eYSIP-2017/Fi_Pi_/Readme.txt

Hello,
This repo contains the documentation and codes of the project 
FiPi- Adapter board development for Firebird V using Raspberry Pi
