eYSIP-2017/Fi_Pi_/Project Report/report.pdf

## eYSIP2017

### Fi-Pi Raspberry-Pi Adaptor

### Board for Firebird-V

### Interns:- Milanpreet Singh Tejaswini A Mentors:- Rutuja Ekatpure Deepa Avudiappan Duration of Internship: 22/05/2017 − 07/07/2017

2017, e-Yantra Publication

# Fi-Pi Raspberry-Pi Adaptor Board for Firebird-V

## Abstract

The project aims at developing Raspberry-pi based Adaptor board for Firebird series Robots.As Raspberry- Pi can cater to more applications specifically in domain of image processing and IOT and provides a new feature of onboard computing which was not present in earlier versions Firebird series. Main features included in this Raspberry- pi based firebird are :-

- Differnet communication choices i.e through XBEE,Bluetooth,USB,DB9, or any serial communication protocol of your choice can used for communication purposes.
- Interfacing Camera on board and live image capturing and video streaming enhances its capabilities and horizon of its applications in different domains.

1

### Completion status

The work flow of the project designed and its completion status is as follows:-

Task | Completion Status | Remarks
Understanding Fire-bird and Raspberry-Pi | Completed | Firebird and Raspberry -pi were studied and pins of firebird mapped properly and BAsic op-erations of Raspberry -Pi werev studied
Interfacing ADC and port Expander | Completed | ADC MCP3008 and Port Ex-pander MCP23017 were inter-faced with raspberry-pi and fire-bird by enabling spi and i2c com-munication and installing pack-ages serial and smbus
Powering circuit for pi | Completed | A circuit for powering Raspberry-pi using LM7805BT with 3A cur-rent capacity was designed
Communication pro-tocols | Completed | Communication protocols like XBEE,DB9,USB were tested by sending commands to firebird through pi
LCD and Motion con-trol | Completed | LCD in 4 bit mode was interfaced using pi and motors were oper-ated at different speeds
Camera interfacing | Completed | Camera was interfaced with pi and images, videos were saved on pi.
Adaptor Board PCB | Completed and revised to new version | PCB was designed and tested with firebird.A newer version was designed with some changes
Manual | Completed | Both Hardware and Software manuals were designed incuding all the features ob board with their codes .
www.e-yantra.org | 2

1.1. HARDWARE PARTS

## 1.1 Hardware parts

- List of hardware
1. Raspberry Pi
Download Datasheet , (https://www.raspberrypi.org/documentation/.../RPI-CM-DATASHEET-V1_0.pdf) Vendor Details (http://www.amazon.in/Raspberry-Pi-Model-1GB-Complete/dp/B00T2U7R7I)

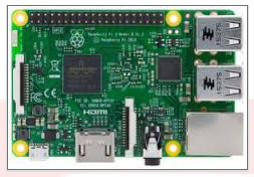
[picture p16: figure]

Figure 1.1: Raspberry Pi

2. FireBird V Robot
Download Datasheet , Vendor Details (http://www.nex-robotics.com/products/fire-bird-v-robots/fire-bird-v-atmega2560-robotic-research-platform.html)

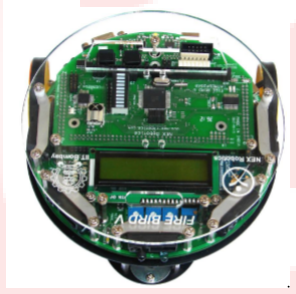
[picture p17: figure]

Figure 1.2: FireBird V Robot

3. MCP23017 IC
Download Datasheet , Vendor Details (http://www.smddevices.com/)

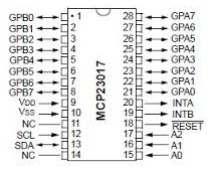
[picture p18: figure]

Figure 1.3: MCP23017 IC

www.e-yantra.org | 3

1.1. HARDWARE PARTS
4. MCP3008 IC
Download Datasheet , (https://cdn-shop.adafruit.com/datasheets/MCP3008.pdf) Vendor Details (http://www.dnatechindia.com/MCP3008-10-Bit-ADC.html)

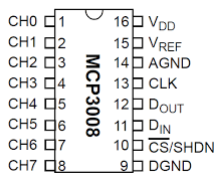
[picture p19: figure]

Figure 1.4: MCP3008 IC

5. FT232 IC
Download Datasheet , Vendor Details (http://www.dnatechindia.com/ft-232-usb-uart-ic.html)

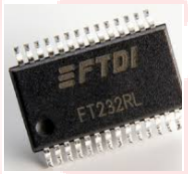
[picture p20: figure]

Figure 1.5: FT232 IC

6. MAX202 IC
Download Datasheet , Vendor Details (https://www.tanotis.com/products/tanotis-2pcs-maxim-integrated-products-max202-max202ese-max202ese)


Figure 1.6: MAX202 IC

7. LM324 IC
Download Datasheet , Vendor Details (http://www.dnatechindia.com/LM324.html)
www.e-yantra.org | 4

1.1. HARDWARE PARTS

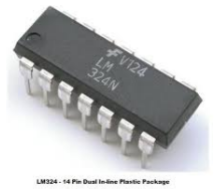
[picture p21: figure]

Figure 1.7: LM324 IC

8. LM7805 IC
Download Datasheet , (https://www.sparkfun.com/datasheets/Components/LM7805.pdf) Vendor Details (http://www.dnatechindia.com/LM7805.html)

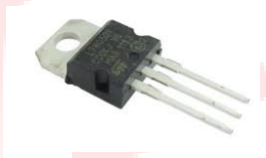
[picture p22: figure]

Figure 1.8: LM7805 IC

9. LM1117 IC
Download Datasheet , Vendor Details (http://www.dnatechindia.com/lm-1117-1-8-v-smd-voltage-regulator.html) Vendor Details (http://www.dnatechindia.com/LM7805.html)

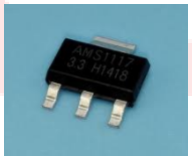
[picture p23: figure]

Figure 1.9: LM1117 IC

10. LED
11. Resistor
12. Bargraph LED
13. Switches
14. Header pins
www.e-yantra.org | 5

1.2. SOFTWARE USED

## 1.2 Software used

- MobaXterm Download Link (http://mobaxterm.mobatek.net/MobaXterm_Setup_9.4.msi)
Personal Edition 9.4
- Raspbian Jessie Download Link (https://downloads.raspberrypi.org/raspbian_latest) Disk Image Version 2
- Autodesk Eagle Download Link (http://www.cadsoftusa.com/download-eagle/) Version 8.2.1
- XCTU Download Link (http://www.digi.com/products/xbee-rf-solutions/xctu-software/xctu#productsupport-utilities)
- Win32 Disk Imager Download Link (http://sourceforge.net/projects/win32diskimager/)
- SD card Formatter Download Link (https://www.sdcard.org/downloads/formatter_4/eula_windows/)
- DHCP server Download Link (http://www.dhcpserver.de/cms/release_notes/2-5-2/) Version 2.5.2
- Serial Terminal Download Link (https://serial-port-terminal.en.softonic.com/)

## 1.3 Assembly of hardware

### Circuit Diagram

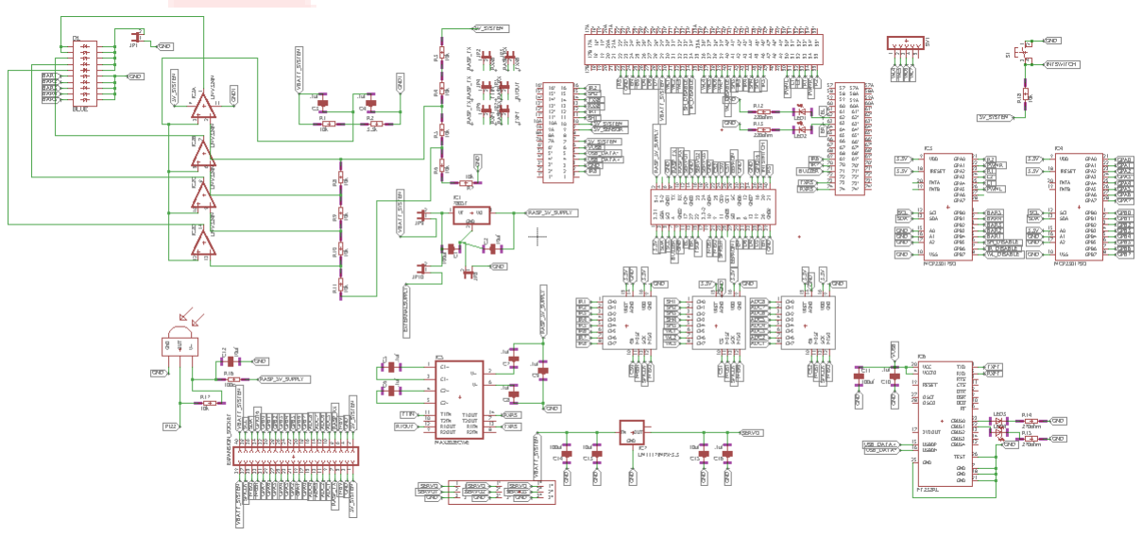
[picture p24: figure]

Figure 1.10: schematic

For more details refer to github link Fi-Pi schematics (https://github.com/eYSIP-2017/eYSIP-2017_Fi_Pi/blob/master/Documents/PCB_Schematics/Fi-Pi.sch)

www.e-yantra.org | 6

1.3. ASSEMBLY OF HARDWARE

### Eagle Layout

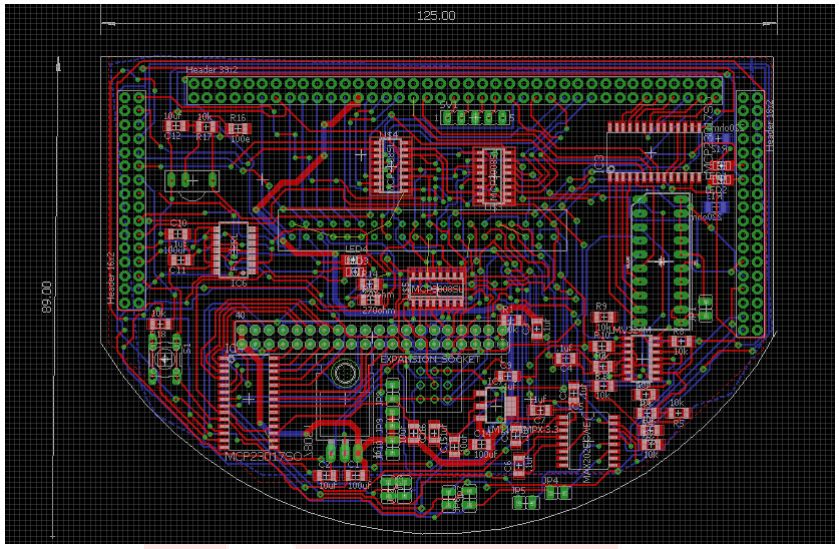
[picture p25: figure]

Figure 1.11: PCB board layout

For more details refer to github link Fi-Pi layout (https://github.com/eYSIP-2017/eYSIP-2017_Fi_Pi/blob/master/Documents/PCB_Schematics/Fi-Pi.brd)

## Steps for Assembling the parts

### Step 1

Get the PCB etched with the gerber file created from the eagle board layout.

www.e-yantra.org | 7

1.3. ASSEMBLY OF HARDWARE

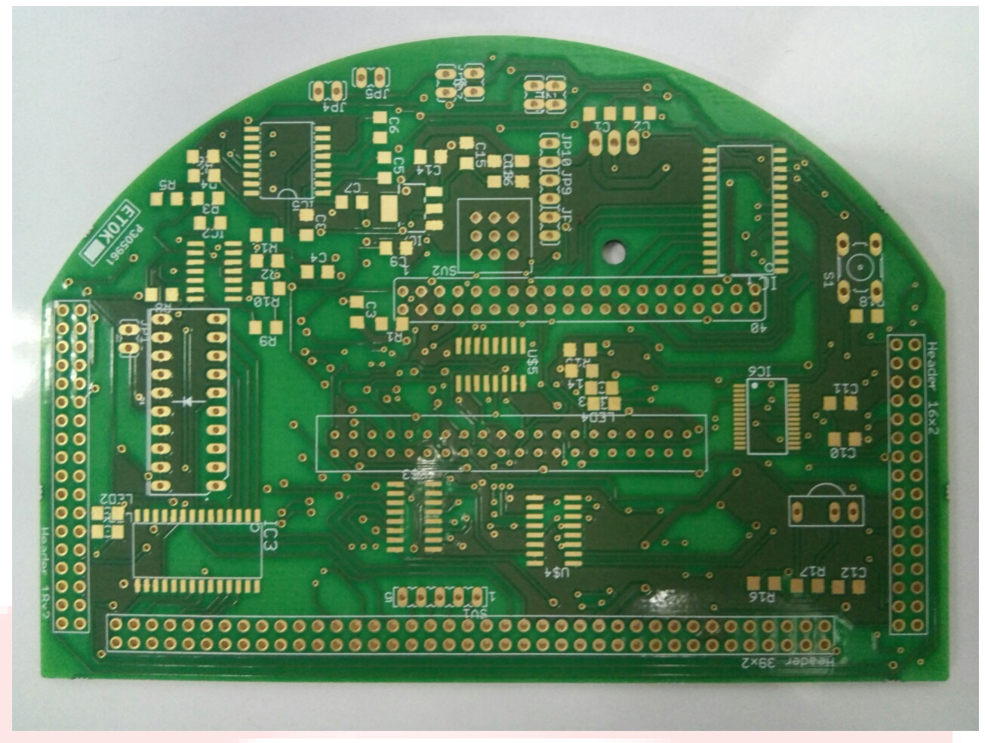
[picture p26: figure]

Figure 1.12: PCB board layout

### Step 2

Place the SMD and Through hole components appropriately in proper orientation and location. Finally solder them

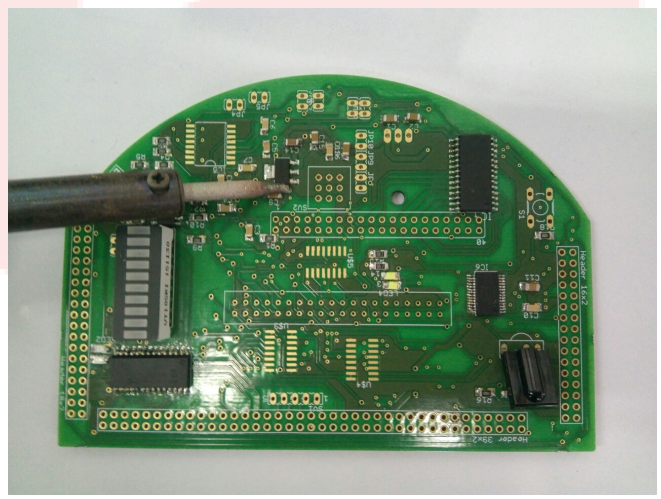
[picture p27: figure]

Figure 1.13: PCB board layout

### Step 3

The final PCB looks as shown below.

www.e-yantra.org | 8

1.4. SOFTWARE AND CODE

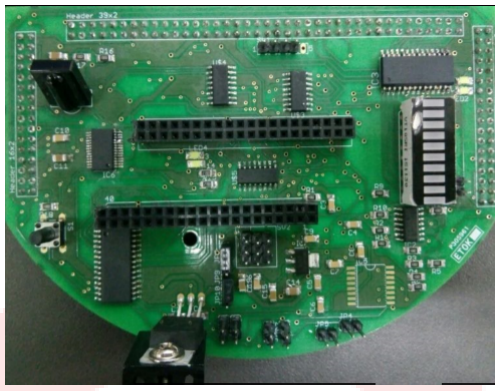
[picture p28: figure]

Figure 1.14: PCB board layout

## 1.4 Software and Code

Github link (https://github.com/eYSIP-2017/eYSIP-2017_Fi_Pi/tree/master/codes/Experiments) for the repository of code

## 1.5 Future Work

Raspberry-pi is a good option for IOT applications so a website can be designed which could be linked to the Raspberry-pi enabled Firebird and data from firebird can be regularly sent let be the sensor values and displayed on the site and stored for further applications.
It may help in tracking conditions of environment from internet and making plant watering bot by detecting plants in the garden through image processing and water them by detecting the humidity and hence watering accordingly.
www.e-yantra.org | 9

1.6. BUG REPORT AND CHALLENGES

## 1.6 Bug report and Challenges

Some changes in Hardware (PCB) have been made and a newer version of PCB is designed:-

- External powering port with external separate battery
- Raspberrypi pin header modified for plug and play directly
- Transistors are interfaced instead of jumpers for changing the communication platform from one to another and hence can be controlled through software means.
- Motors moved to Pi pin header and LCD to port expander beacuse LCD is somewhat useless as we can do ssh and check it on laptop and hence saving power.
www.e-yantra.org | 10

# Bibliography

[1] Raspbian Jessie OS Installation, https://www.engadget.com/2012/09/04/raspberrypi-getting-started-guide-how-to/
[2] SPI | and | I2C | communication | protocol
www.byteparadigm.com/applications/introduction-to-i2c-and-spiprotocols/
[3] I2C configuration https://learn.adafruit.com/ adafruits-raspberry-pilesson-4-gpio-setup/ configuring-i2c
[4] Pulse Width Modulation http://www.electronics-tutorials.ws/blog/ pulsewidth-modulation.html
[5] Software Interrupt https://www.techopedia.com/de

nition/22195/software-interrupt

[6] Port expander MCP23017 IC https://www.mathworks.com/examples/matlab/4547-add-digital-i-o-pins-to-raspberry-pi-hardware-using-mcp23017
[7] Queries regarding Raspberry Pi http://stackoverflow.com/questions/tagged/raspberrypi
[8] Libraries | for | progrmming | different | IC’s | or | modules
https://github.com/adafruit

11
