eYSIP-2017/Fi_Pi_/Documents/poster_final_update.pdf

# FIPI-Adaptor board for Firebird V using Raspberry Pi B+

### Milan Preet Singh, Tejaswini A, Mentors: Rutuja, Deepa

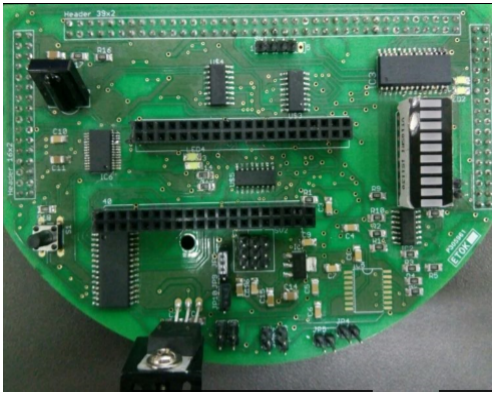
[picture p29: figure]
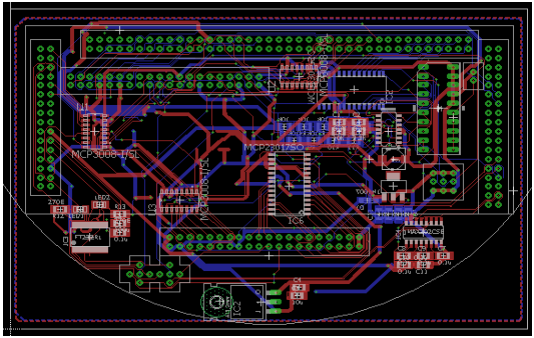
[picture p30: figure]

### e-Yantra Summer Internship Project 2017

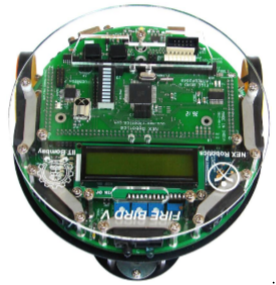
[picture p31: figure]

Currently Firebird V robot comes with ATMEGA2560, 8051, ARM7 adaptor board. Using a raspberry pi based adaptor board would add to the functionality of the robot. The idea is to integrate the features of RPi to Firebird V robot.
This will facilitate any
(1)On-board computations
(2)Imageprocessing(PiCamera )
(3) IOT applications
Objective | What does the Adaptor Board contain?

1.Raspberry Pi B+
2.MCP3008 ADC (8 channel, 10-bit, SPI ) 3.MCP23017 Port Expander (I2C protocol) 4.LM117 (Powering Servo motors)
5.Bar graph LED (Battery level indication) 6.Raspberry Pi port expansion socket

## Communication with Rpi

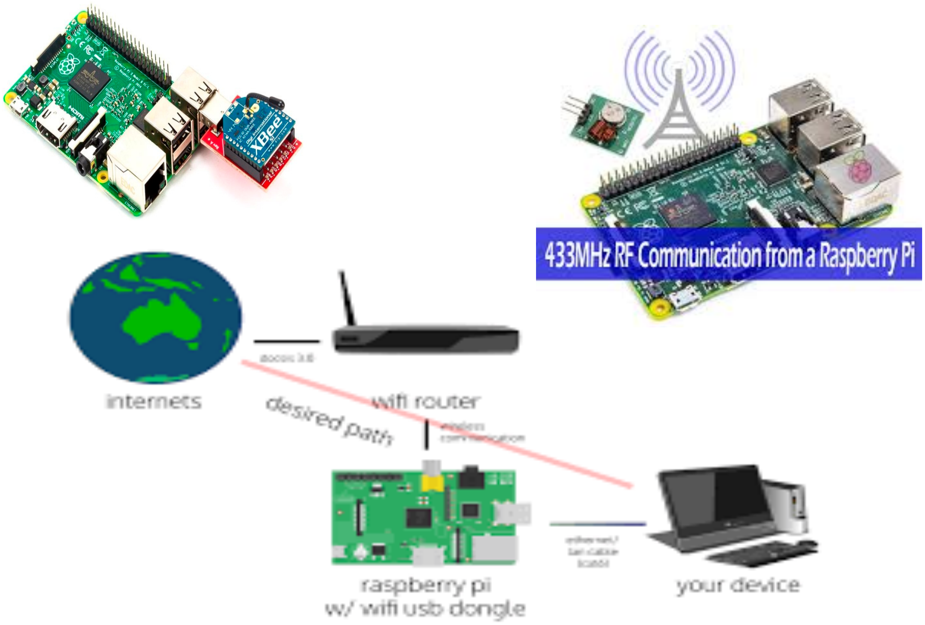
[picture p32: figure]

1.The OS of raspberry pi can be accessed by SSH (Mobaxterm or Putty) 2.Parallel communication (with LCD) 3.UART communication:
*RS232(wired)
*USB(wired)
*Xbee (wireless)
*Bluetooth (wireless)
However, any other communication type is also supported since the rpi port expander socket has extra RX TX pins.
