eYSIP-2017/Fi_Pi_/Documents/progress_ppt.pdf

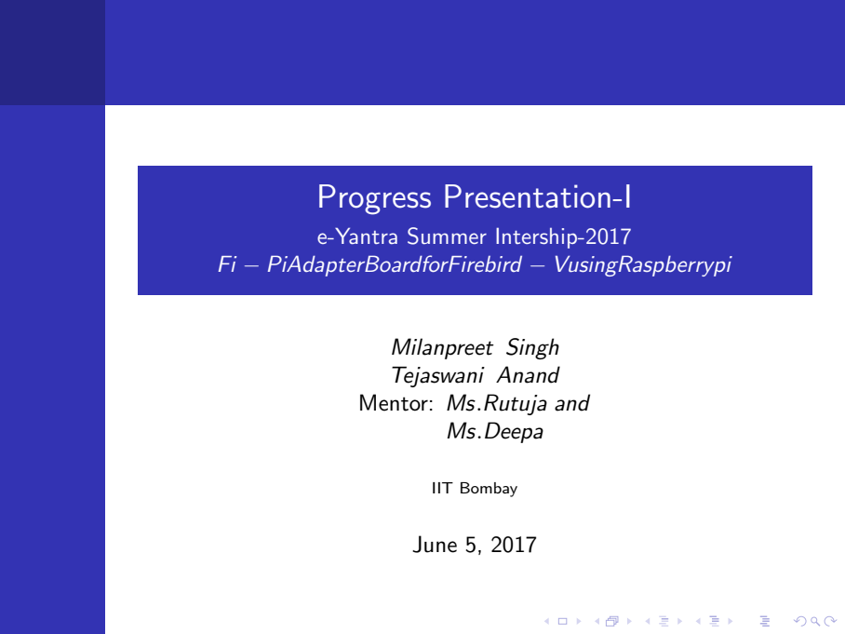
[picture p33: figure]
Progress Presentation-I; e-Yantra Summer Intership-2017; Milanpreet Singh Tejaswani Anand Mentor: Ms.Rutuja and Ms.Deepa; IIT Bombay; June 5, 2017

# Fi − PiAdapterBoardforFirebird − VusingRaspberrypi

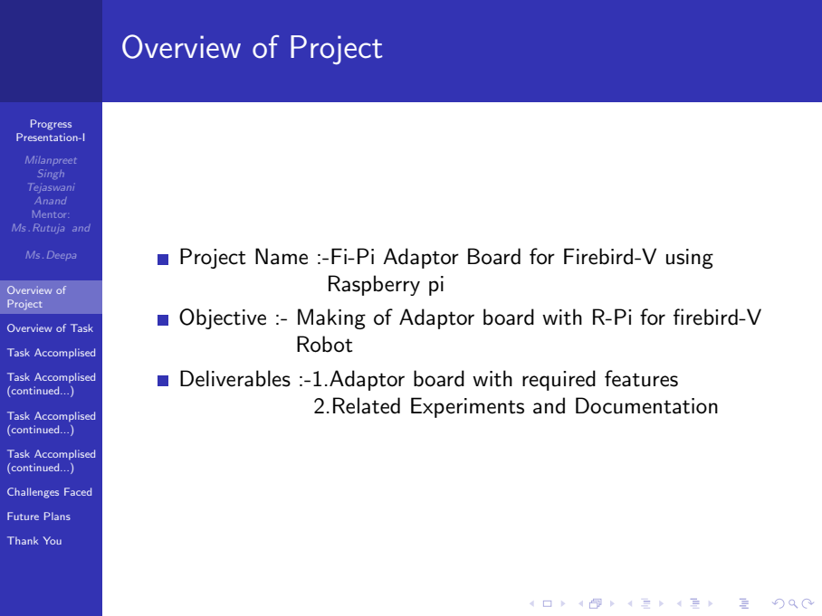
[picture p34: figure]
Progress Presentation-I; Milanpreet Singh Tejaswani Anand Mentor: Ms.Rutuja and; Ms.Deepa; Overview of Project; Overview of Task; Task Accomplised; Task Accomplised (continued...); Challenges Faced; Future Plans; Thank You; Raspberry pi; Robot; 2.Related Experiments and Documentation

# Project Name :-Fi-Pi Adaptor Board for Firebird-V using

# Objective :- Making of Adaptor board with R-Pi for firebird-V

# Deliverables :-1.Adaptor board with required features

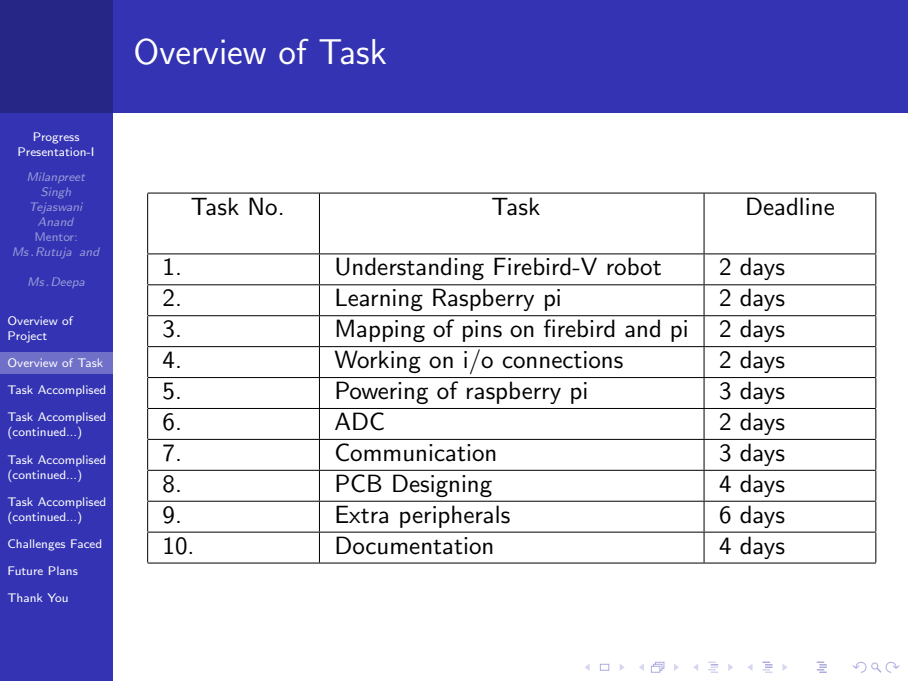
[picture p35: figure]
Progress Presentation-I; Milanpreet Singh Tejaswani Anand Mentor: Ms.Rutuja and; Ms.Deepa; Overview of Project; Overview of Task; Task Accomplised; Task Accomplised (continued...); Challenges Faced; Future Plans; Thank You; Task No.; Task; Deadline; Learning Raspberry pi; 2 days; Working on i/o connections; Powering of raspberry pi; 3 days; ADC; Communication; PCB Designing; 4 days; Extra peripherals; 6 days; Documentation

1. | Understanding Firebird-V robot | 2 days
3. | Mapping of pins on firebird and pi | 2 days

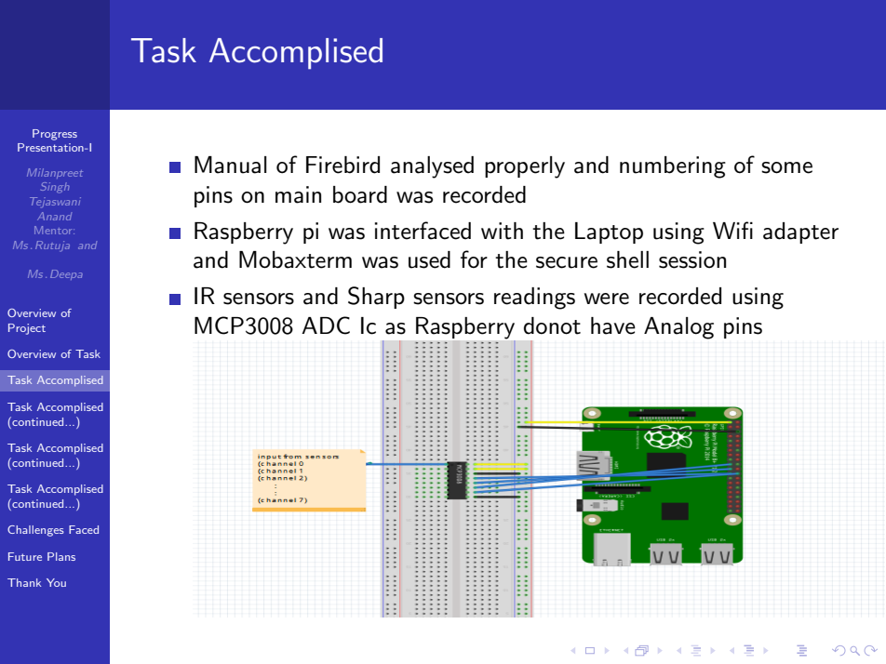
[picture p36: figure]
Progress Presentation-I; Milanpreet Singh Tejaswani Anand Mentor: Ms.Rutuja and; Ms.Deepa; Overview of Project; Overview of Task; Task Accomplised; Task Accomplised (continued...); Challenges Faced; Future Plans; Thank You; pins on main board was recorded

# Manual of Firebird analysed properly and numbering of some

# Raspberry pi was interfaced with the Laptop using Wifi adapter and Mobaxterm was used for the secure shell session

# IR sensors and Sharp sensors readings were recorded using MCP3008 ADC Ic as Raspberry donot have Analog pins

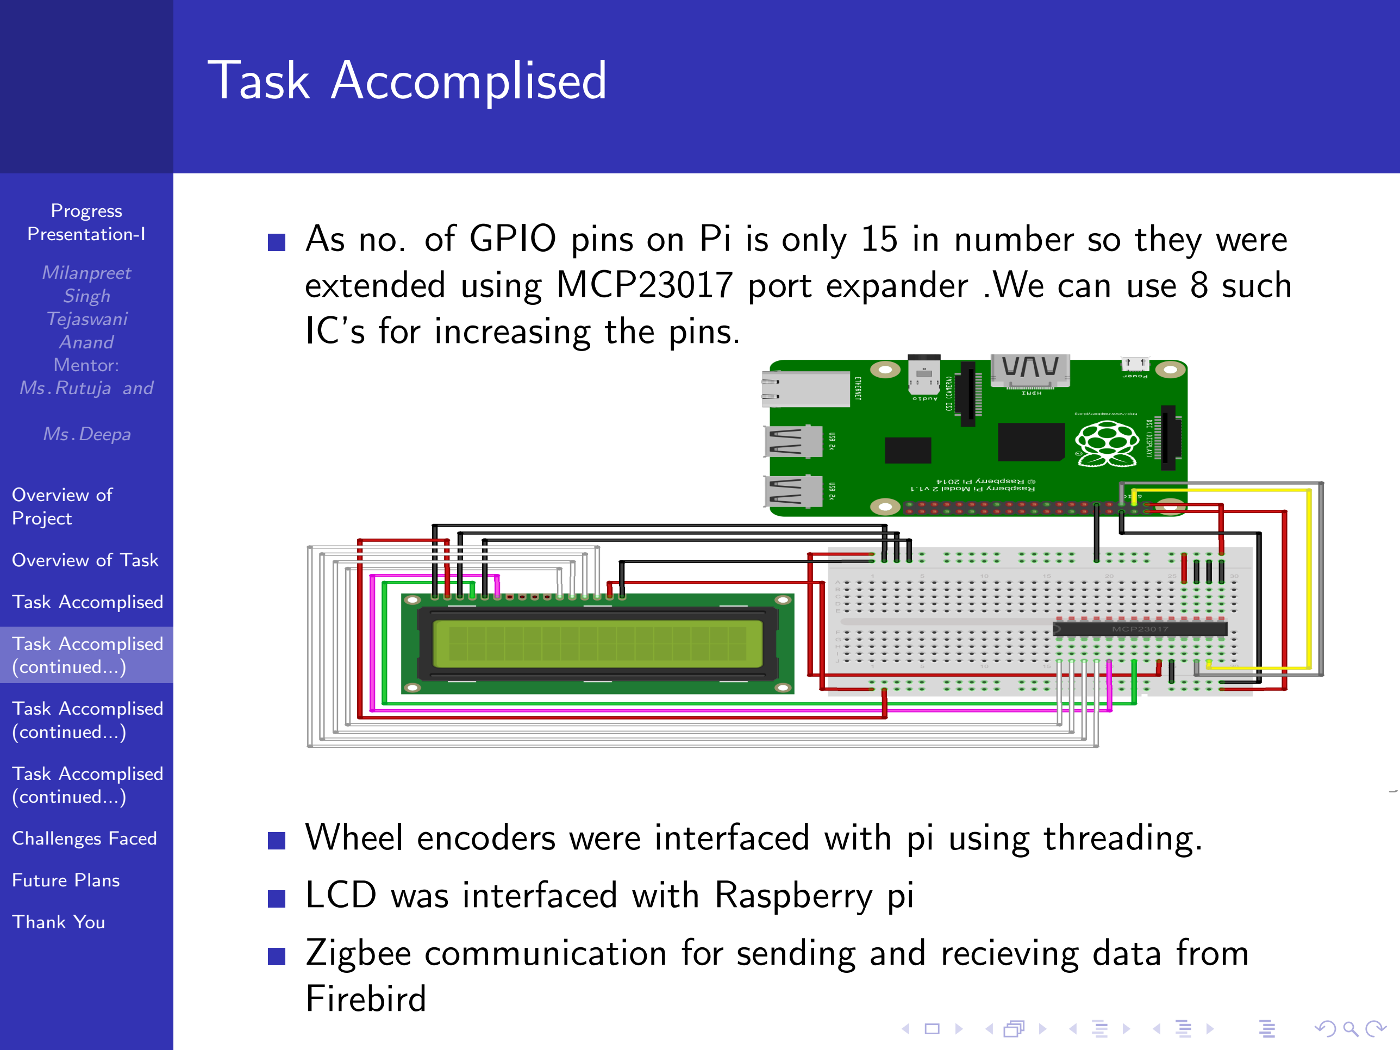
[picture p37: figure]
Progress Presentation-I; Milanpreet Singh Tejaswani Anand Mentor: Ms.Rutuja and; Ms.Deepa; Overview of Project; Overview of Task; Task Accomplised; Task Accomplised (continued...); Challenges Faced; Future Plans; Thank You; IC’s for increasing the pins.; LCD was interfaced with Raspberry pi; Firebird

# As no. of GPIO pins on Pi is only 15 in number so they were extended using MCP23017 port expander .We can use 8 such

Wheel encoders were interfaced with pi using threading.

# Zigbee communication for sending and recieving data from

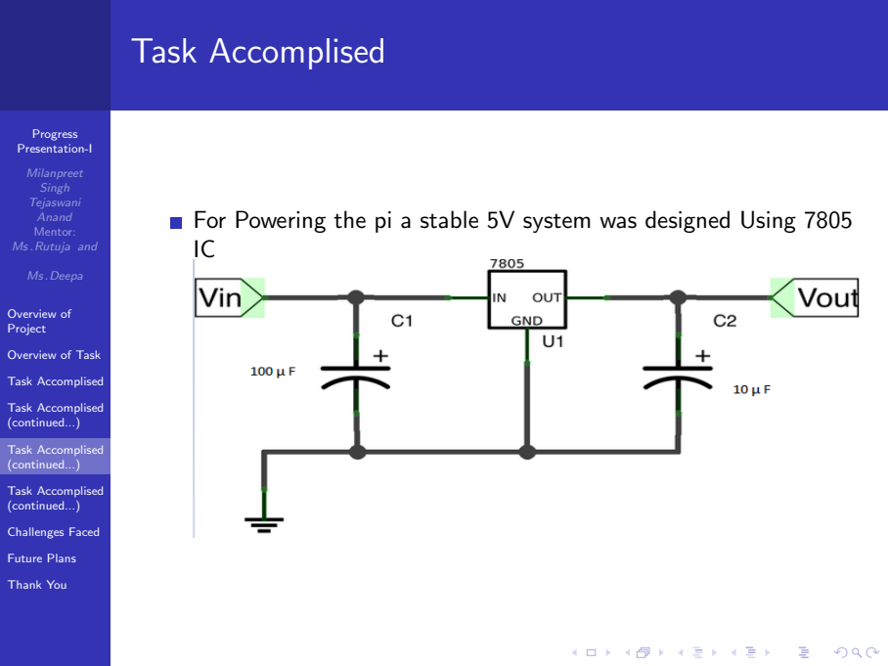
[picture p38: figure]
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

# For Powering the pi a stable 5V system was designed Using 7805

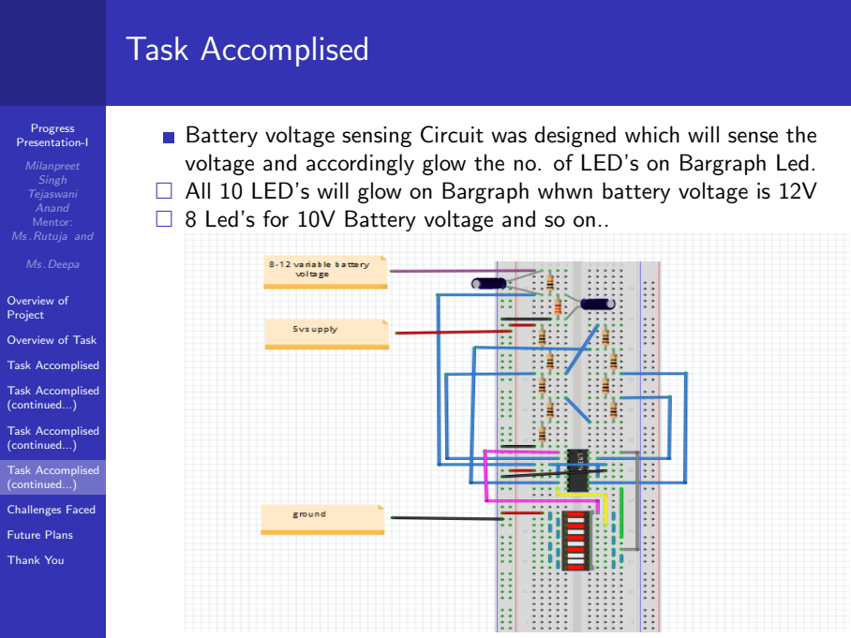
[picture p39: figure]
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

# Battery voltage sensing Circuit was designed which will sense the

voltage and accordingly glow the no. of LED’s on Bargraph Led.

# All 10 LED’s will glow on Bargraph whwn battery voltage is 12V

8 Led’s for 10V Battery voltage and so on..

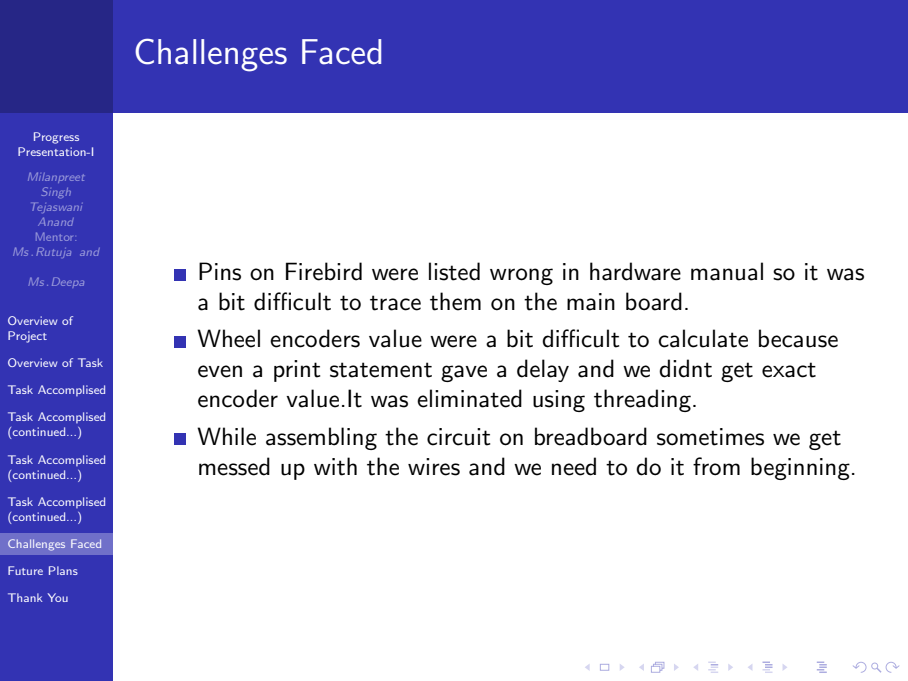
[picture p40: figure]
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

# Pins on Firebird were listed wrong in hardware manual so it was

a bit difficult to trace them on the main board.

# Wheel encoders value were a bit difficult to calculate because even a print statement gave a delay and we didnt get exact

encoder value.It was eliminated using threading.

# While assembling the circuit on breadboard sometimes we get

messed up with the wires and we need to do it from beginning.

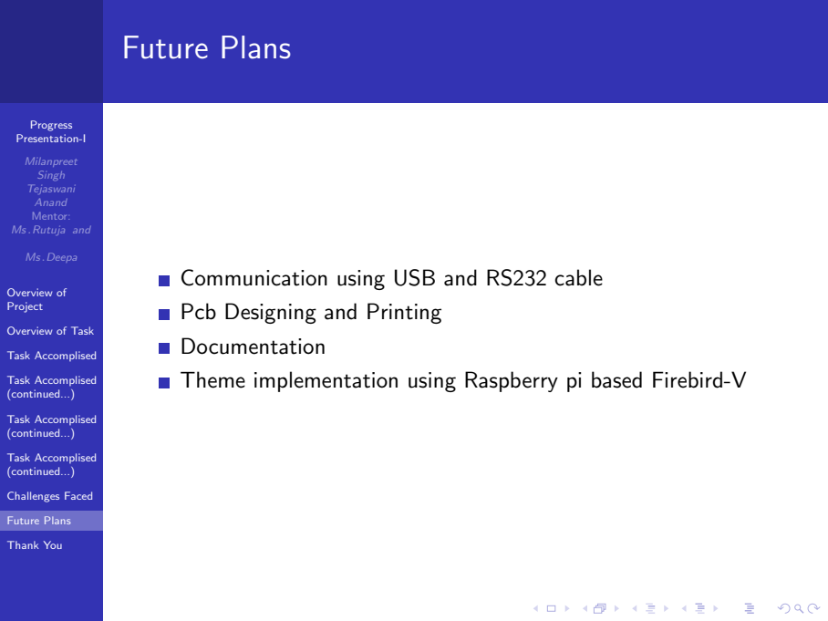
[picture p41: figure]
Progress Presentation-I; Milanpreet Singh Tejaswani Anand Mentor: Ms.Rutuja and; Ms.Deepa; Overview of Project; Overview of Task; Task Accomplised; Task Accomplised (continued...); Challenges Faced; Future Plans; Thank You; Communication using USB and RS232 cable; Pcb Designing and Printing; Documentation

# Theme implementation using Raspberry pi based Firebird-V

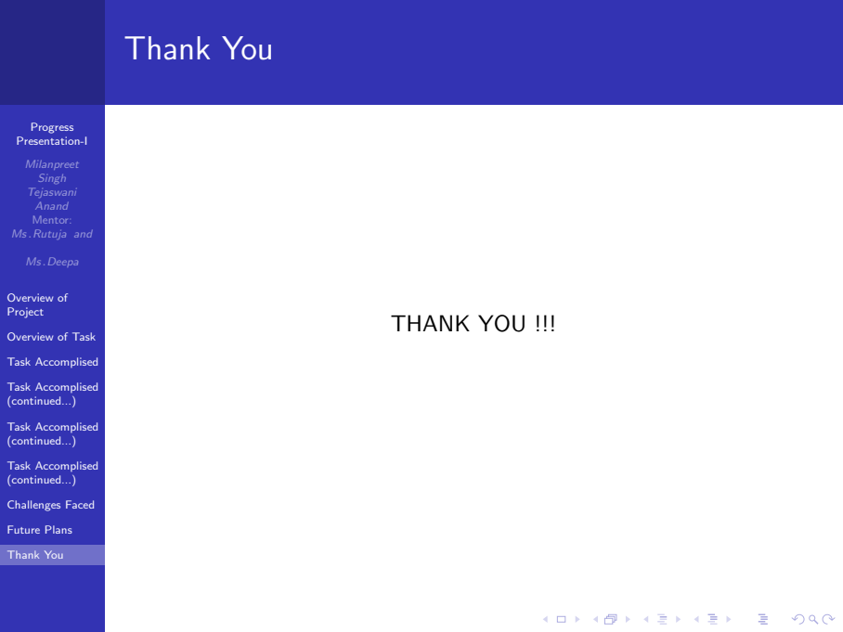
[picture p42: figure]
Progress Presentation-I; Milanpreet Singh Tejaswani Anand Mentor: Ms.Rutuja and; Ms.Deepa; Overview of Project; Overview of Task; Task Accomplised; Task Accomplised (continued...); Challenges Faced; Future Plans; Thank You; THANK YOU !!!
