eYSIP-2017/Fi_Pi_/Documents/poster_final_update.png

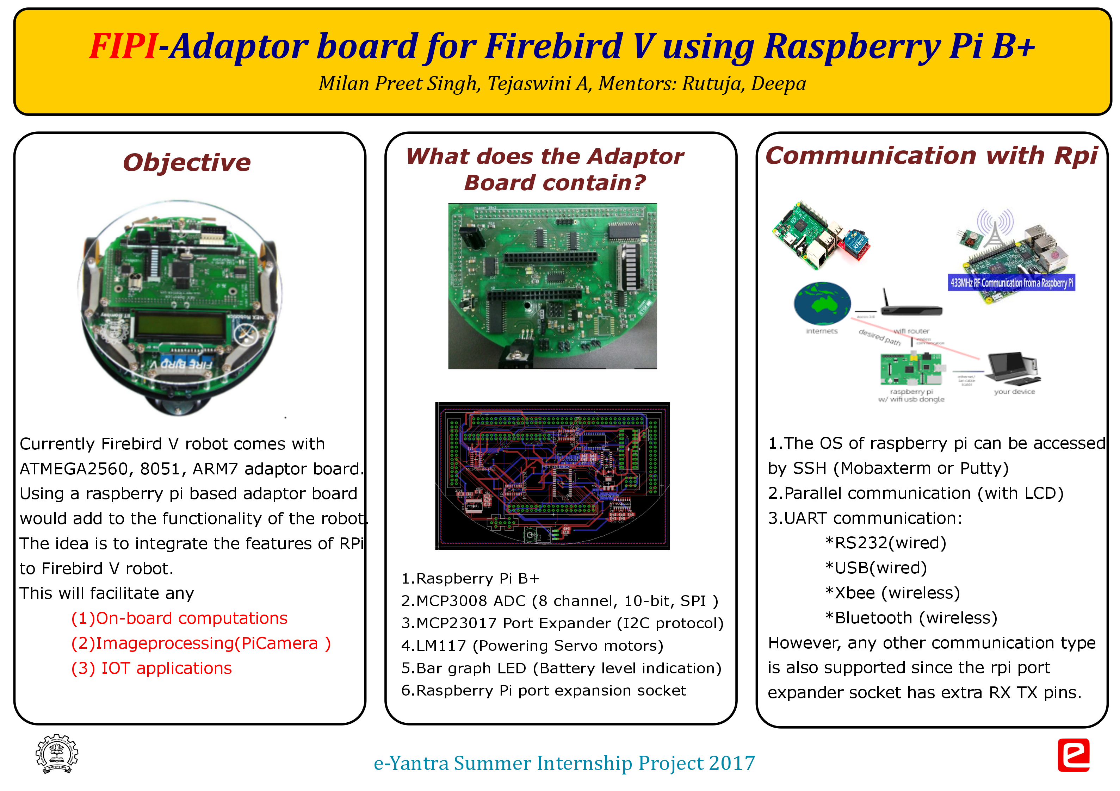
Documents/poster_final_update.png
