eYSIP-2017/Fi_Pi_/Project Report/Adaptor_board.PNG

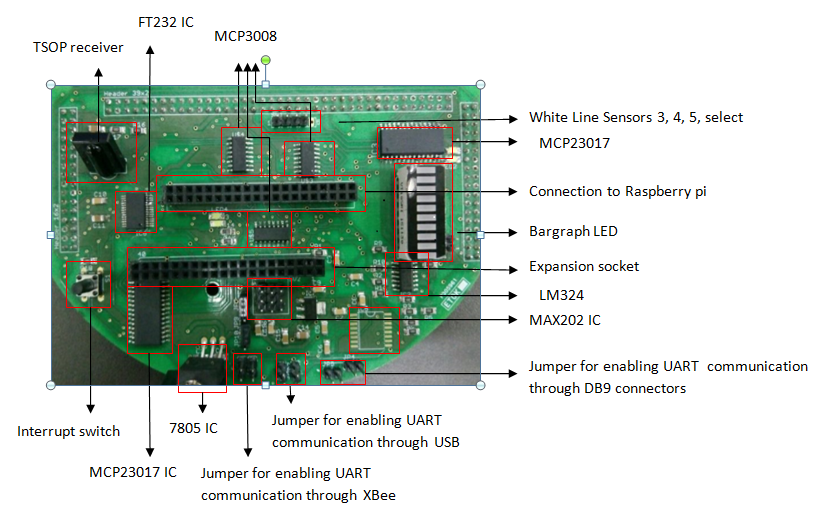
Project Report/Adaptor_board.PNG
