eYSIP-2017/Fi_Pi_/Project Report/led.PNG

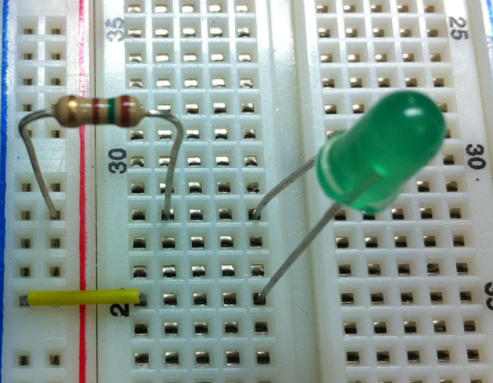
Project Report/led.PNG
