eYSIP-2017/Fi_Pi_/Documents/Manual/Software manual/Software_manual.pdf

DblueFi-Pi

# DredAdaptor Board for Firebird V Robot

Dred | using Raspberry Pi
2
Dred | HARDWARE MAN-

# UAL

1

e-Yantra summer internship 2017

July 5,2017

# Contents

1 Installation of an Operating System on Raspberry Pi | 3

1.6 A comparison between different models and versions of Rasp-

### 2 Establishing Network connection and SSH between pc and

Raspberry pi | 11
2.6.1 | Network settings configuration using DHCP Server(wireless
3 Programming Raspberry-Pi | 22
3.4.1 | Program to access GPIO pin of R-Pi for beeping Buzzer

1

4 References | 46

2

# Chapter 1

# Installation of an Operating System on Raspberry Pi

## 1.1 Objective

This chapter will help a Windows or a Linux user to install an operating system on Raspberry Pi successfully.

## 1.2 Prerequisites

- An idea about Windows or Linux operating system and their features.

## 1.3 Hardware Requirement

1. Raspberry Pi (I will be using Version 2 Model-B+)
2. Adapter (To power up an R-pi)
3. SD card reader
4. PC (either Linux or Windows machine)

## 1.4 Software Requirement

1. Winrar or any other zipping software
2. Utorrent or any suitable downloading platform
3. win32DiskManager
4. Memoy card formatter

3

## 1.5 Theory and Description

The Raspberry Pi is a series of small single-board computers developed in the United Kingdom by the Raspberry Pi Foundation.Raspberry Pi is a low cost, credit-card sized computer that plugs into a computer monitor or TV, and uses a standard keyboard and mouse. It is a capable little device that enables people of all ages to explore computing, and to learn how to program in languages like Scratch and Python.The Raspberry Pi 2 uses a Broadcom BCM2836 SoC with a 900 MHz 32-bit quad-core ARM Cortex-A7 processor, with 256 KB shared L2 cache Its capable of doing everything youd expect a desktop computer to do, from browsing the internet and playing high-definition video, to making spreadsheets, word-processing, and playing games.

4

## 1.6 A comparison between different models and versions of Raspberry pi

Parameter | Model A | Model A+ | Model B | Model B+ | Generation 2 Model B
Target price(in US dollars): | 25 | 20 | 35 | 25 | 35
SoC: | Broadcom BCM2835 (CPU, GPU, DSP, SDRAM, one USB port) | Broadcom BCM2835 (CPU, GPU, DSP, SDRAM, one USB port) | Broadcom BCM2835 (CPU, GPU, DSP, SDRAM, one USB port) | Broadcom BCM2835 (CPU, GPU, DSP, SDRAM, one USB port) | Broadcom BCM2836 (CPU, GPU, DSP, SDRAM, one USB port)
CPU: | 700 MHz single-core ARM1176JZF-S | 700 MHz single-core ARM1176JZF-S | 700 MHz single-core ARM1176JZF-S | 700 MHz single-core ARM1176JZF-S | 900 MHz quad-core ARM Cortex-A7
Memory (SDRAM): | 256 MB (shared with GPU) 512 MB | 256 MB (shared with GPU) | 512 MB (shared with GPU) | 512 MB (shared with GPU) | 1 GB (shared with GPU)
USB 2.0 ports: | 1 (direct from BCM2835 chip) | 1 (direct from BCM2835 chip) | 2 (via the on-board 3-port USB hub)[38] | 4 (via the on-board 5-port USB hub) | 4 (via the on-board 5-port USB hub)
On-board storage: | SD / MMC / SDIO card slot (3.3 V with card power only) | MicroSD slot[32] | SD / MMC / SDIO card slot | MicroSD slot | MicroSD slot
On-board network: | None | None | 10/100 Mbit/s Ethernet (8P8C) USB adapter on the third/-fifth port of the USB hub (SMSC lan9514-jzx) | 10/100 Mbit/s Ethernet (8P8C) USB adapter on the third/-fifth port of the USB hub (SMSC lan9514-jzx) | 10/100 Mbit/s Ethernet (8P8C) USB adapter on the third/-fifth port of the USB hub (SMSC lan9514-jzx)
Low-level pe-ripherals: | 8 GPIO | 17 GPIO plus the same spe-cific functions, and HAT ID bus | 8 GPIO | 17 GPIO | 17 GPIO
Power rat-ings: | 300 mA (1.5 W) | 200 mA (1 W) | 700 mA (3.5 W) | 600 mA (3.0 W) | 800 mA(4.0 W)

5

## 1.7 Experiment

Instructions for installing operating system in Raspberry Pi:
Download Raspbian software from raspberry pi website. It should be available in the form of a zip file. Download it from the following link: https://www.raspberrypi.org/downloads/ Also download win32DiskManager from the following link:http://sourceforge.net/projects/win32diskimager/ and memorycard formatter (SD Formatter) from :-https://www.sdcard.org/downloads/formatter_4/eula_windows/then install it.

A windows user should follow these steps:

- Insert an sd card(4GB or greater size) into the laptop in the memory card slot if available or use a memory card reader.First format the complete memory card using SD Formatter software downloaded from the above link then Run win32DiskImager and choose the Raspbian image and select the drive corresponding to your sd card.
- Click ”Write” to copy the files of the image on to the sd card.
- Eject SD card and insert it into the sd card slot of the Raspberry Pi.

A Linux user should follow these steps:

- Insert an sd card(4GB or greater size) into the laptop in the memory card slot if available or use a memory card reader.
- Run df -h to see what devices are currently mounted. The new device that has appeared is your SD card. The left column gives the device name of your SD card; it will be listed as something like /dev/mmcblk0p1 or /dev/sdd1. The last part (p1 or 1 respectively) is the partition number but you want to write to the whole SD card, not just one partition. Therefore you need to remove that part from the name (getting, for example, /dev/mmcblk0 or /dev/sdd) as the device for the whole SD card. Note that the SD card can show up more than once in the output of df; it will do this if you have previously written a Raspberry Pi image to this SD card, because the Raspberry Pi SD images have more than one partition.
- Note down your device name. You need to unmount it so that files can’t be read or written to the SD card while you are copying over the SD image.
- Run umount /dev/sdd1, replacing sdd1 with whatever your SD card’s device name is (including the partition number). If your SD

6

card shows up more than once in the output of df due to having multiple partitions on the SD card, you should unmount all of these partitions.

- In the terminal, write the image to the card with the command below, making sure you replace the input file if= argument with the path to your .img file, and the /dev/sdd in the output file of= argument with the right device name. This is very important, as you will lose all data on the hard drive if you provide the wrong device name. Make sure the device name is the name of the whole SD card as described above, not just a partition of it; for example sdd, not sdds1 or sddp1; or mmcblk0, not mmcblk0p1.

dd bs=4M if=2015-05-05-raspbian-wheezy.img of=/dev/sdd

Please note that block size set to 4M will work most of the time; if not, please try 1M, although this will take considerably longer.

Also note that if you are not logged in as root you will need to prefix this with sudo.

- The dd command does not give any information of its progress and so may appear to have frozen; it could take more than five minutes to finish writing to the card. If your card reader has an LED it may blink during the write process. To see the progress of the copy operation you can run pkill -USR1 -n -x dd in another terminal, prefixed with sudo if you are not logged in as root. The progress will be displayed in the original window and not the window with the pkill command; it may not display immediately, due to buffering.

Instead of dd you can use dcfldd; it will give a progress report about how much has been written.

You can check what’s written to the SD card by dd-ing from the card back to another image on your hard disk, truncating the new image to the same size as the original, and then running diff (or md5sum) on those two images.

- The SD card might be bigger than the original image, and dd will make a copy of the whole card. We must therefore truncate the new image to the size of the original image. Make sure you replace the input file if= argument with the right device name. diff should report that the files are identical.

dd bs=4M if=/dev/sdd of=from-sd-card.img truncate –reference 2015-05-05-raspbian-wheezy.img from-sd-card.img diff -s from-sd-card.img 2015-05-05-raspbian-wheezy.img

- Run sync; this will ensure the write cache is flushed and that it is safe to unmount your SD card.

7

- Remove the SD card from the card reader and insert it into Raspberry Pi’s SD card slot. [1]

After inserting the SD card into Raspberry Pi follow these steps:

1. Connect the keyboard and mouse.Use HDMI cable to connect the board to the VGA monitor
2. Power on the board and the monitor. You will notice a set of code running on the monitor.
3. After a while a software configuration tool opens.


Figure 1.1:

4. In case the size of the SD card is greater than 4GB you can select the 1st option i.e.Expand file system in the configuration tool as shown above.
5. Select the internationalisation options.

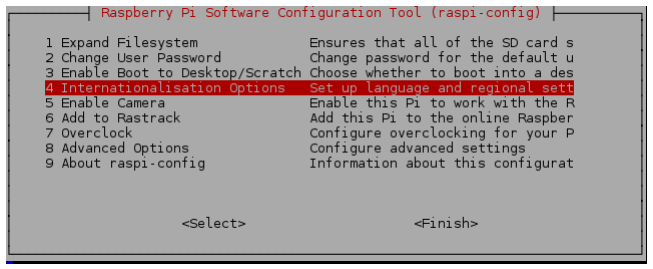
[picture p93: figure]

Figure 1.2:

6. Change the keyboard and language settings as per your choice. Default keyboard will be of UK. Step by step change to US keyboard is as shown:
- First select the option change Keyboard layout and click ok

8


Figure 1.3:

- Then select the respective keyboard you are using and if you dont find your kind then select any of the generic types.

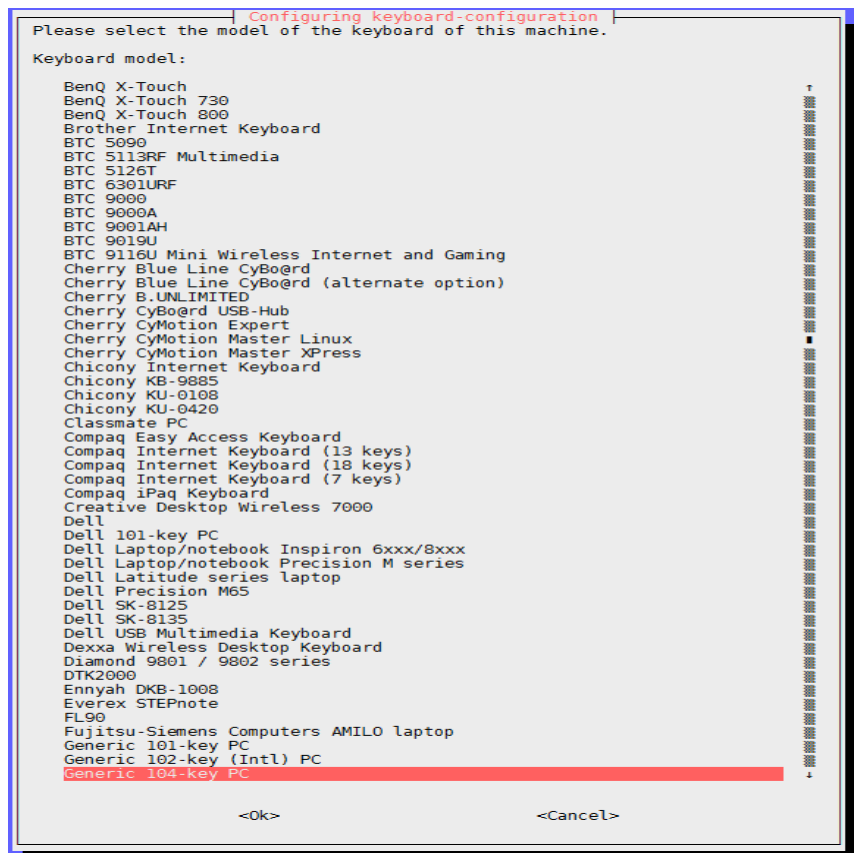
[picture p94: figure]

Figure 1.4:

- Select ”English US” which will be available at the top. Then for the rest of the process simply click enter till you reach the main configuration menu.

9


Figure 1.5:

7. Click on finish using the keyboard by using arrow keys and enter key.
8. Click on ”ok” when prompted for reboot.
9. Upon reboot, enter ’pi’ as user id and ’raspberry’ as password. Then type ’startx’ to enter the graphical interface.
10. The linux based raspbian interface will be displayed on the monitor. Some of the softwares will be preloaded such as wolfram, python etc.
11. The command prompt will be the lx terminal.

With this we end the installation of Raspbian OS in R-Pi.

10

# Chapter 2

# Establishing Network connection and SSH between pc and Raspberry pi

## 2.1 Objective

this chapter focuses on learning how to establish a network connection in an R-Pi and how to connect a PC to a Raspberry Pi using SSH connection(i.e. remote control).

## 2.2 Prerequisites

One should be aware of :

- Basic terminal commands.
- The ssid and password of a wireless network to which an R-Pi has to be connected.

## 2.3 Hardware Requirement

1. Raspberry Pi (I will be using Version 2 Model B+)
2. Monitor,HDMI cable,Keyboard,Mouse (This an optional mode of connecting an R-Pi.
3. Wireless adapter
4. Power adapter
5. PC(either Windows or Linux)

11

## 2.4 Software Requirement

MobaXterm(for Windows user)

12

## 2.5 Theory and Description

Secure Shell is a program to log into another computer over a network, to execute commands in a remote machine, and to move files from one machine to another. It provides strong authentication and secure communications over insecure channels. It is a replacement for rlogin, rsh, rcp, and rdist. SSH protects a network from attacks such as IP spoofing, IP source routing, and DNS spoofing. An attacker who has managed to take over a network can only force ssh to disconnect. He or she cannot play back the traffic or hijack the connection when encryption is enabled. When using ssh’s slogin (instead of rlogin) the entire login session, including transmission of password, is encrypted; therefore it is almost impossible for an outsider to collect passwords. [2] Applications of SSH

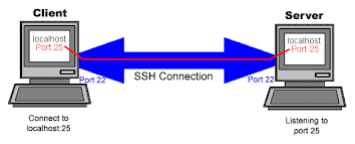
[picture p95: figure]

Figure 2.1: [3]

or OpenSSH protocol

- For login to a shell on a remote host (replacing Telnet and rlogin)
- For executing a single command on a remote host (replacing rsh)
- For setting up automatic (passwordless) login to a remote server (for example, using OpenSSH)
- Secure file transfer
- In combination with rsync to back up, copy and mirror files efficiently and securely
- For forwarding or tunneling a port (not to be confused with a VPN, which routes packets between different networks, or bridges two broadcast domains into one).
- For using as a full-fledged encrypted VPN. Note that only OpenSSH server and client supports this feature.

13

- For forwarding X from a remote host (possible through multiple intermediate hosts)
- For browsing the web through an encrypted proxy connection with SSH clients that support the SOCKS protocol.
- For securely mounting a directory on a remote server as a filesystem on a local computer using SSHFS.
- For automated remote monitoring and management of servers through one or more of the mechanisms discussed above.
- For development on a mobile or embedded device that supports SSH.[1]

MobaXterm

MobaXterm is a tool used for remote computing. In a single Windows application, it provides loads of functions that are tailored for programmers, webmasters, IT administrators and pretty much all users who need to handle their remote jobs in a more simple fashion.It provides all the important remote network tools (SSH, X11, RDP, VNC, FTP, MOSH, ...) and Unix commands (bash, ls, cat, sed, grep, awk, rsync, ...) to Windows desktop, in a single portable exe file which works out of the box.

There are many advantages of having an All-In-One network application for your remote tasks, e.g. when you use SSH to connect to a remote server, a graphical SFTP browser will automatically pop up in order to directly edit your remote files. Your remote applications will also display seamlessly on your Windows desktop using the embedded X server.[4]

14

## 2.6 Establishing a network connection

Before we can start using a Raspberry Pi remotely we need to configure its network settings.There are two ways to configure network setting:

- One is using DHCP server (wireless connection)
- The other one is by assigning a static IP

### 2.6.1 Network settings configuration using DHCP

Server(wireless settings)

1. Insert the SD card (with Raspbian OS already written) into the micro SD slot in an R-Pi.
2. Connect the wireless adapter, keyboard , mouse and monitor (using a HDMI cable) to the Raspberry Pi.
3. Power on the board and monitor.You will notice a set of code running on the monitor.
4. Enter the set user name and password and then type startx command to launch the GUI.

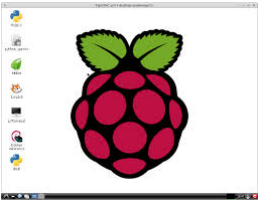
[picture p96: figure]

Figure 2.2:

5. Click on the icon at the bottom-left on the screen. This is the start icon.
6. Select LXTerminal option to open a terminal window

15

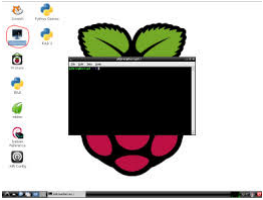
[picture p97: figure]

Figure 2.3:

7. Some of the previous versions of Raspbian OS do not support wireless module. To know about the version you are using type uname -a. To upgrade to the latest one type ”sudo apt-get upgrade”.
8. Connect your wireless adapter . To check if its connected type lsusb(We used D-link adapter which is highlighted in yellow)


Figure 2.4:

9. Now type sudo nano /etc/network/interfaces and press enter. You will see the following window:

16

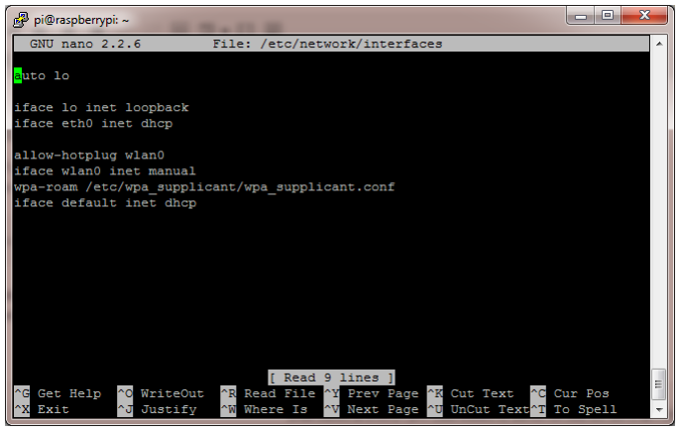
[picture p98: figure]

Figure 2.5:

10. Change the code by adding the following lines:


Figure 2.6:

11. Add in the SSID(username) and Password of your wifi. Then for changes to take effect type sudo /etc/init.d/networking restart
12. Type ifconfig to obtain the IP address of R-Pi etc. It will be under wlan0(written as inet address).

17

### 2.6.2 Network settings using static IP method

The router normally distributes the dynamic IP addresses but it isnt guaranteed that it will assign the same IP address every time. This can cause problems if you are trying to connect to your Raspberry Pi remotely. And hence we can assign a static IP. In order to do so follow these steps:

1. Open the LXTerminal and type the following command
cat /etc/network/interfaces
2. Before you make changes to the document you should be aware of your current IP address, the broadcast IP and the Mask Use the command ifconfig to retrieve this information To find your gateway address type the following command: sudo route nee
3. In order to edit the interfaces file type sudo nano /etc/network/interfaces
4. Remove the following line iface eth0 inet dhcp and add the following: iface eth0 inet static
address 192.168.0.x
netmask 255.255.255.0
network 192.168.0.0
broadcast 192.168.0.255
gateway 192.168.0.y
5. Save the file using Ctrl+X, Y.
6. For changes to take effect type sudo /etc/init.d/networking restart and reboot the system.

18

## 2.7 Establishing an SSH connection

To start using a Raspberry Pi remotely follow these steps:

1. A windows user should download MobaXterm (latest version) using the following link: http://mobaxterm.mobatek.net/
2. Run the .exe file and open the application.

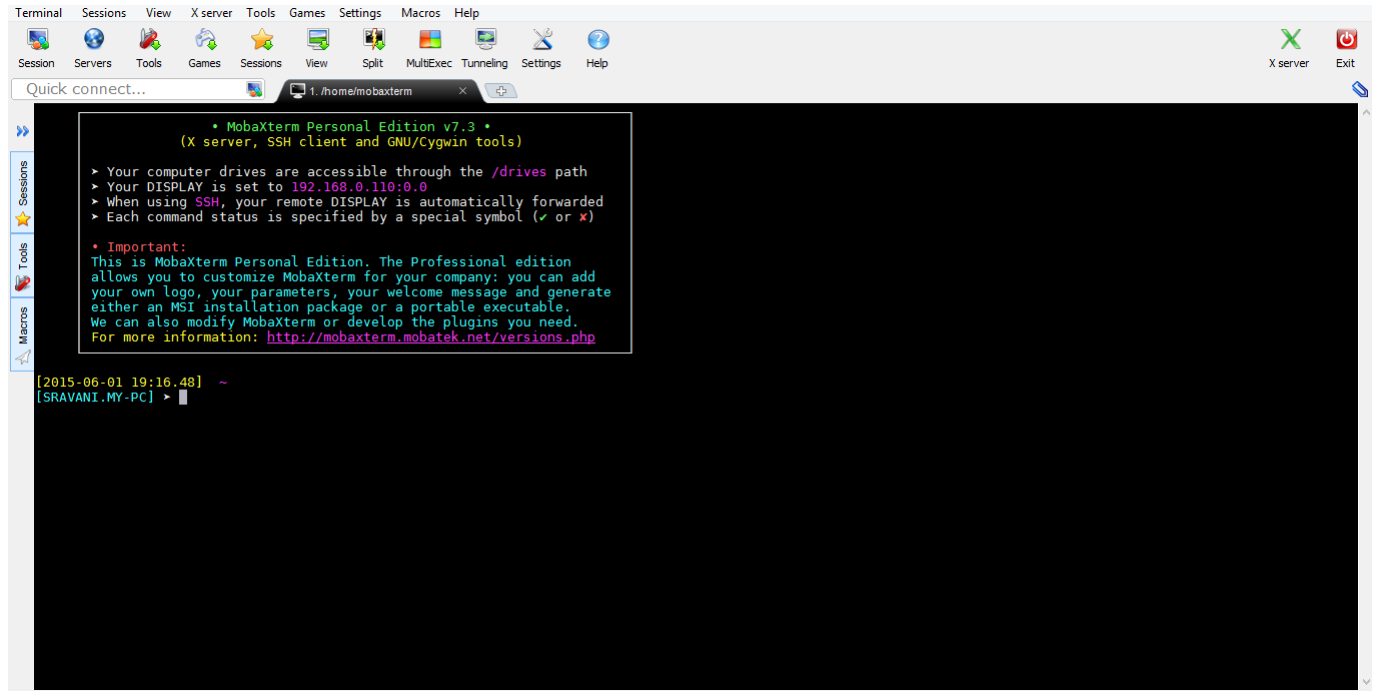
[picture p99: figure]

Figure 2.7:

3. Then select the session option on the toolbar.


Figure 2.8:

19

4. Click on the SSH option. A settings window opens as shown


Figure 2.9:

5. Enter the IP address of the R-pi in the Remote host field and in the ’Advanced SSH settings’ option configure the remote environment either as ’Interactive shell (terminal based)’ or as an ’LXDE desktop(GUI based)’and click OK
6. If you are using the Interactive shell environment login to the R-Pi using the following command: ssh -X pi@192.168.0.4 (IP address of pi) and then enter the login id and password to start using the Pi remotely.
7. If you are using the LXDE desktop i.e. the GUI environment then use LX terminal icon to start programming the Pi.

20


Figure 2.10:

8. Also the established session is saved. So the next time you want to access directly click on the R-Pi’s address mentioned in the saved session option to start using the Pi remotely.


Figure 2.11:

Note: A linux user needn’t download any Xterm file. They can directly start accessing the R-Pi using the command: ssh -X pi@192.168.0.4 (IP address of pi) and then entering the login id and password for using the Pi remotely.

21

# Chapter 3

# Programming Raspberry-Pi

## 3.1 Prerequisites

1. PyScripter (version 2.7 or above)
2. Mobaxterm (for windows users)

## 3.2 Raspberry-pi J8 Header

Expansion Header
The Raspberry Pi 2 Model B+ board contains a single 40-pin expansion header labelled as ’J8’ providing access to 26 GPIO pins. (Pins 1, 2, 39 and 40 are also labelled below.)

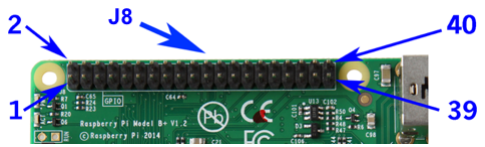
[picture p100: figure]

Figure 3.1: [3]

22

The diagram below illustrates the pin out diagram of Raspberry Pi 2:


Figure 3.2: [4]

You must have noticed that the board contains pins named as GPIO (that are used for interfacing input and output devices) and hence in order to refer to the R-Pi pins there exists two modes:

1. BCM mode: Referring the pins with the GPIO number
2. Board mode: Referring the pins using the IC pin numbers.

## 3.3 Different ways of programming

Before we write a code to access GPIO pins of the Pi let’s understand the different ways to program Pi.

1. GUI based programming using IDLE3. In order to do so follow these steps:
- First, load up IDLE 3 by double-clicking the icon on your
LXDE desktop(either on the monitor or using Mobaxterm as explained in the previous tutorial based on establshing a SSH connection).

23

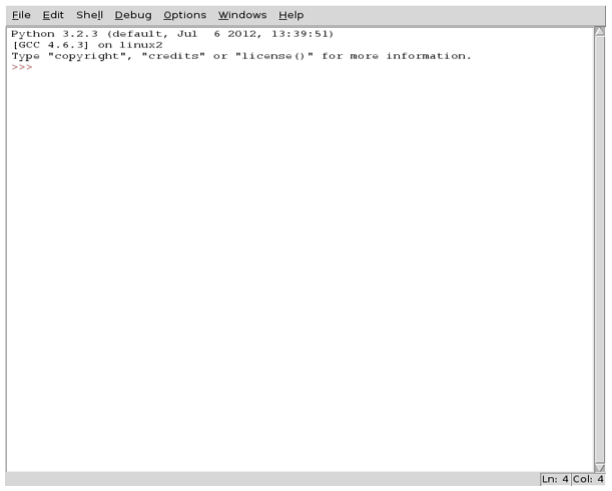
[picture p101: figure]

Figure 3.3: [1]

- Click File,New Window, which will then bring up a new blank window which you can type in.
- Now click File,Save As and save your file in the desired folder.
- Click Run, and then Run Module or simply press F5.
2. Terminal based programming:
- Using PyScripter and MobaXterm: PyScripter is a free and open-source Python IDE used for programming in Python.In order to download PyScripter use the following link https://code.google.com/p/pyscripter/ (I use version 2.5.3).
(a) Open the application. You will see a window like this:
(b) Delete the text already present and type your program. Once you finish typing the program goto File ¿ Save As and save the program.
(c) Now open MobaXterm. On the left side you can see the files in /home/pi/ directory and you also have some small icons on the toolbar. Click on the icon ’Upload to current folder’ as shown:

24

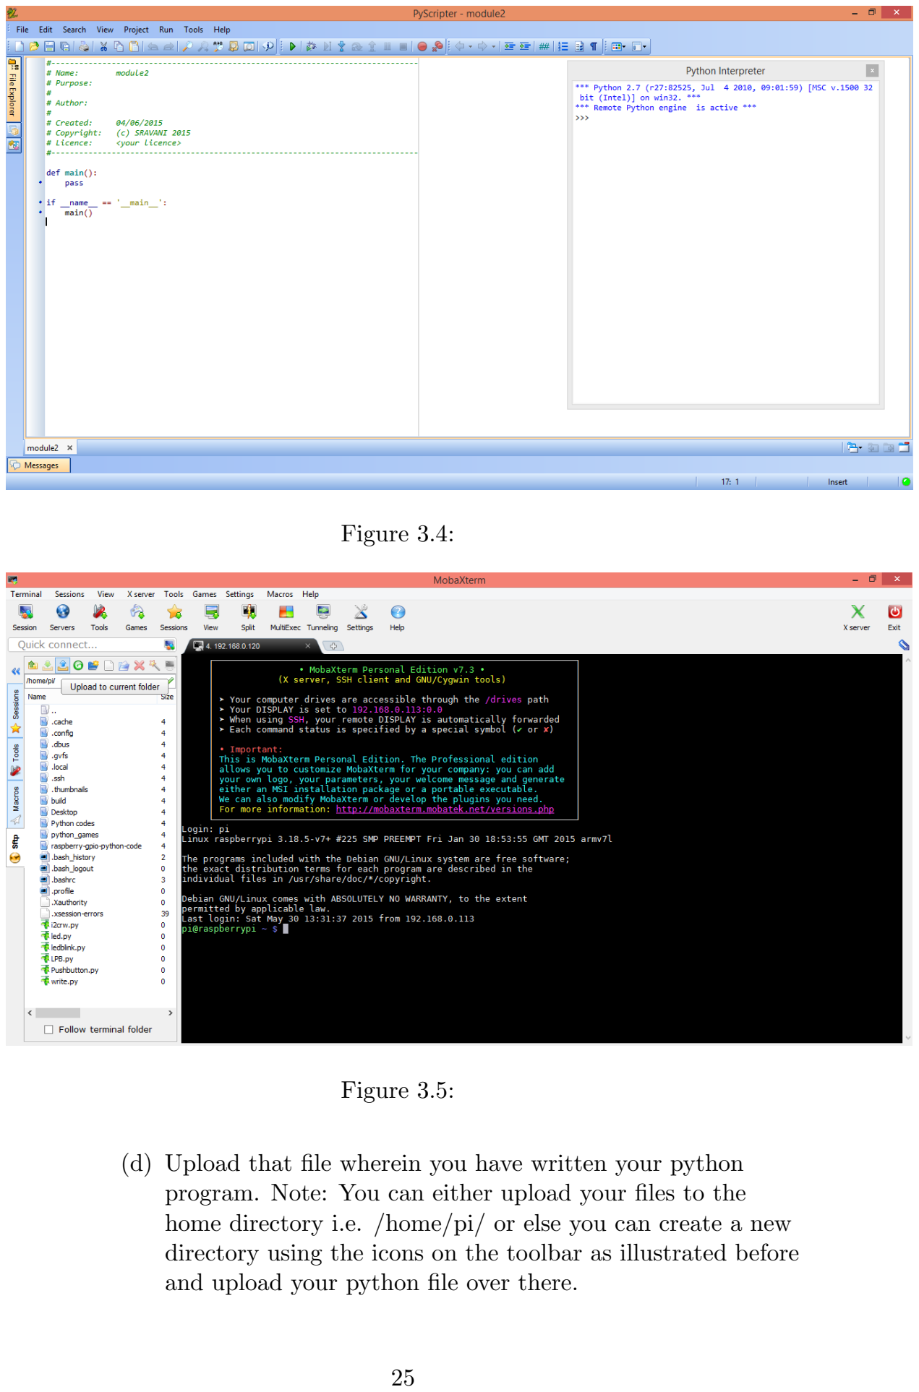
[picture p102: page 27]

Figure 3.4:

Figure 3.5:

(d) Upload that file wherein you have written your python program. Note: You can either upload your files to the home directory i.e. /home/pi/ or else you can create a new directory using the icons on the toolbar as illustrated before and upload your python file over there.

25

(e) After you have uploaded the code then type the following command on the terminal to execute the code python filename.py. In case you have uploaded the file to a directory other than home directory then change the path by typing cd directoryname and then sudo python filename.py (Note: In order to execute files form any directory other than home directory dont forget to use cd command before your directory name and textitsudo python command before your file name that you want to execute.)

Figure 3.6:

- Using Notepad++ and LXTerminal(or MobaXterm): Notepad++ is a source code and a Windows text editor that is widely used by programmers.(It is more efficient than other text editors because it prompts you with indentation related errors that count in python programming)
(a) Open the application and a create a new file.

26


Figure 3.7:

(b) Type your python code and then save it as filename.py
(c) After that follow the steps(3-5) mentioned in the above method i.e using PScripter and MobaXterm.
- Using MobaXterm(for remote operation) or LXTerminal: In this method we can create a python file on the terminal window in the following way:
(a) Open the MobaXterm or LXTerminal.
(b) Type the command touch filename.py to create a file in a directory say home directory
(c) Once the file is created in order to edit it type the command nano filename.py

27

Figure 3.8:

(d) A blank file opens as shown


Figure 3.9:

(e) Type the required code and save the contents by typing Ctrl + X,Y (to save the file type Y)
(f) Then press enter to exit the editor onto terminal window.
(g) You can now execute the file by using the command sudo python filename.py(Don’t forget to change the directory if your file is not saved in the home directory.PLease refer the steps mentioned before in the document)

Note: Just in case you want to view the contents of the file on the terminal window type cat filename.py

Now we are all set to write basic programs to access GPIO pins in your R-Pi

28

## 3.4 Experiments

All codes of other experiments can be accessed through:- https://github.com/eYSIP-2017/eYSIP-2017_Fi_Pi/tree/master/codes/Experiments (https://github.com/eYSIP-2017/eYSIP-2017_Fi_Pi/tree/master/codes/Experiments)

### 3.4.1 Program to access GPIO pin of R-Pi for beeping

Buzzer by push button

- Buzzer is connected to pin no. 4
- One pin of the push button is connected to Ground
- The other pin of the push button is connected to pin no. 18

29

Code:-

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

# t o use Raspberry Pi GPIO p in numbers

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

GPIO. se t up ( 1 8 , GPIO. IN , pull up d own=GPIO.PUD UP)

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

30

### 3.4.2 IR sensors interfacing

The objective is to Interface the ADC MCP3008 to 8 IR sensors.ADC MCP3008 operates on SPI protocol.

Enabling SPI

Enabling using raspi-config
Run the following command:
Sudo raspi-config
This will launch the raspi-config utility. Select option 8 ”Advanced Options”.


Figure 3.10:

Select the ”SPI” option.

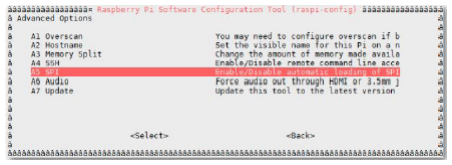
[picture p103: figure]

Figure 3.11:

Set the option to ”Yes”.

Select ”OK”.

Select ”Finish”.

Reboot for the changes to take effect : sudo reboot
SPI is now enabled.

31

Installing SPI Wraper in python

In order to read data from the SPI bus in Python we can install a library called ‘py-spidev’. To install it we first need to install ‘python-dev’: sudo apt-get install python2.7-dev Then to finish we can download ‘py-spidev’ and compile it ready for use, run the following commands: wget https://github.com/Gadgetoid/py-spidev/archive/master.zip unzip master.zip rm master.zip cd py-spidev-master sudo python setup.py install cd .. You should now be ready to either communicate with add-on boards us- ing their own libraries (e.g. the PiFace) or other SPI devices.

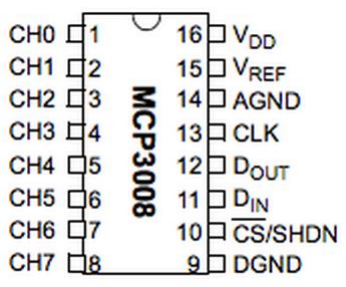
[picture p104: figure]

Figure 3.12: MCP3008 IC

IR sensors are connected to ADC 1 to the specific channels as shown :-

IR sensor number | ADC channel
IR 1 | 0
IR 2 | 1
IR 3 | 2
IR 4 | 3
IR 5 | 4
IR 6 | 5
IR 7 | 6
IR 8 | 7

32

Code:-

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

# Func t ion t o read SPI d a t a from MCP3008 c h i p

# Channel must be an i n t e g e r 0−7

# Func t ion name : getADC

# In p u t : c h annel

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

def getADC ( ch annel ) :
i f ( channel >7) or ( channel <0):
return −1
r=s p i . x f e r ([ 1 , ( 8+ ch annel ) << 4 , 0 ] ) a d c o u t =(( r [ 1]& 3 ) << 8 ) + r [ 2 ]
#p r i n t ( a d c o u t )

# i f ( a dc o u t <600 and a dc o u t >100) : #p r i n t ( ” 1 ” )

#e l s e :

#p r i n t ( ” 0 ” )

pr int ( ” adc output : { 0 : 4 d}” . format ( a d c o u t ) )

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

#v a l u e u s i n g s p i commun icat ion

while 1 :
for i in range ( 8 ) :
pr int ( ”−−−−−−−−−−−−−−−−−−−−−−−−−−−−−−−−−−−−−−−−−−−−−−−−−−−−−−−−−” ) pr int ( ” a n al o g s e n s o r ” )
pr int ( i )
getADC ( i )
pr int ( ”−−−−−−−−−−−−−−−−−−−−−−−−−−−−−−−−−−−−−−−−−−−−−−−−−−−−−−−−−” ) s l e e p ( 2 )

33

### 3.4.3 LCD interface with port expander

In this tutorial we will be interfacing LCD with R-pi using port expander .MCP 23017 is based on I@C protocol.

Enabling I2C

Enabling using raspi-config
Run the following command:
Sudo raspi-config
This will launch the raspi-config utility. Select option 8 ”Advanced Options”.

Figure 3.13:

Select the ”I2C” option.


Figure 3.14:

Set the option to ”Yes”.

Select ”OK”.

Select ”Finish”.

Reboot for the changes to take effect :
sudo reboot
I2C is now enabled.

When you power up or reboot your Pi you can check the i2c module is

34 running by using the following command :
lsmod — grep i2c
That will list all the modules starting with i2c . If it lists i2c bcm2708 then the module is running correctly.
Once you have connected your hardware double check the wiring. Make sure 3.3V is going to the correct pins and you have got not short circuits. Power up the Pi and wait for it to boot.
Type the command:
sudo i2cdetect -y 1
You should the output as:
LCD is connected to portA of port expander 1 inthe order :- vspace0.3cm


Figure 3.15: [4]

LCD pin | port expander 1 port A pin
RS | pA0
EN pA1
D5 | pA2
D4 | pA3
D6 | pA4
D7 | pA5

35

Code:-

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

# Func t ion name : i n i t i a l i z e m c p

# In p u t : None

# Ou tpu t : I n i t i a l i z e s MCP23017 IC

# Example c a l l : i n i t i a l i z e m c p ( )

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

bus . w ri t e b y t e d a t a (DEVICE,OLATB, 0 )

return

# Func t ion name : cm d s e t 4 b i t

# In p u t : None

# Ou tpu t : S e t s t h e 16 x2 LCD in 4 b i t mode

# L og ic : Command 0 x30 i s s e n t t h r i c e and command 0 x20 i s s e n t

# | once t o i n i t i a l i z e t h e LCD

# Example c a l l : cm d s e t 4 b i t ( )

def cmd s e t 4bi t ( ) :
| time . s l e e p ( 1. 0 / 1 0 0 0 ) bus . w ri t e b y t e d a t a (DEVICE,OLATB, 0 b00000000 ) bus . w ri t e b y t e d a t a (DEVICE,OLATA, 0 b00110000 ) bus . w ri t e b y t e d a t a (DEVICE,OLATB, 0 b00000100 ) time . s l e e p ( 5. 0 / 1 0 0 0 ) bus . w ri t e b y t e d a t a (DEVICE,OLATB, 0 b00000000 )
| time . s l e e p ( 1. 0 / 1 0 0 0 ) bus . w ri t e b y t e d a t a (DEVICE,OLATA, 0 b00110000 )
| 36

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

time . s l e e p ( 1. 0 / 1 0 0 0 )
bus . w ri t e b y t e d a t a (DEVICE,OLATA, 0 b00110000 ) bus . w ri t e b y t e d a t a (DEVICE,OLATB, 0 b00000100 ) time . s l e e p ( 5. 0 / 1 0 0 0 )
bus . w ri t e b y t e d a t a (DEVICE,OLATB, 0 b00000000 )

time . s l e e p ( 1. 0 / 1 0 0 0 )
bus . w ri t e b y t e d a t a (DEVICE,OLATA, 0 b00100000 ) bus . w ri t e b y t e d a t a (DEVICE,OLATB, 0 b00000100 ) time . s l e e p ( 5. 0 / 1 0 0 0 )
bus . w ri t e b y t e d a t a (DEVICE,OLATB, 0 b00000000 )

return

# Func t ion name : c o n v e r t

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

# | each and a z e r o i s appended a t t h e end o f each d i g i t

# | ( eg : ’0 f ’ i s c o n v e r t e d t o ’ 0 0 ’ and ’ f 0 ’ )

# Example c a l l : c o n v e r t ( l s t )

def c o n v e r t ( l s t ) :
| f c = [ ]
| l = len ( l s t )
| for i in range ( 0 , l ) :
| j = l s t [ i ]
| temp1 = j [ 0 ] + ’ 0 ’
| temp2 = j [ 1 ] + ’ 0 ’
| t = int ( temp1 , 1 6 ) # r e t u r n s t h e dec im al form o f a s t r i n g ( temp1 )
| u = int ( temp2 , 1 6 )
| f c . append ( t )
| f c . append ( u )
| return f c # o u t p u t l i s t

# Func t ion name : s t r i n g c o n v e r t

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

| 37

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

# | hex v a l u e o f t h e c h a r a c t e r )

# Example c a l l : s t r i n g c o n v e r t ( s )

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

# Func t ion name : c o n v e r s i o n

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

# | c o n t a i n d a t a and commands in t h e form t h a t can be

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

# Example c a l l : c o n v e r s i o n (com , s )

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

# Func t ion name : l c d s t a r t

# In p u t : None

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

time . s l e e p ( 5. 0 / 1 0 0 )
cmd s e t 4bi t ( )

# Func t ion name : commandwrt

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

# | dec im al forma t )

# Ou tpu t : Commands are s e n t t o LCD d i s p l a y one by one

# L og ic : For s e n d i n g commands RS p in o f an LCD i s s e t t o 0 and R/W

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

# Example c a l l : commandwrt (cmd)

def commandwrt (cmd ) :
| l = len (cmd ) bus . w ri t e b y t e d a t a (DEVICE,OLATB, 0 b00000000 ) for i in range ( 0 , l ) : time . s l e e p ( 1. 0 / 1 0 0 0 ) bus . w ri t e b y t e d a t a (DEVICE,OLATA, cmd [ i ] ) bus . w ri t e b y t e d a t a (DEVICE,OLATB, 0 b00000100 ) time . s l e e p ( 5. 0 / 1 0 0 0 ) bus . w ri t e b y t e d a t a (DEVICE,OLATB, 0 b00000000 )

return

# Func t ion name : d a t aw r t

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

# Example c a l l : d a t aw r t ( d a t a )

def datawrt ( data ) :
| l = len ( data ) for i in range ( 0 , l ) : time . s l e e p ( 1. 0 / 1 0 0 0 ) bus . w ri t e b y t e d a t a (DEVICE,OLATA, data [ i ] ) bus . w ri t e b y t e d a t a (DEVICE,OLATB, 0 b00000101 ) time . s l e e p ( 5. 0 / 1 0 0 0 ) bus . w ri t e b y t e d a t a (DEVICE,OLATB, 0 b00000001 )

return

# Func t ion name : l c d c l e a r

# In p u t : None

# Ou tpu t : LCD s c r e e n g e t s c l e a r e d (command = 0 x01 )

| 39

# Example c a l l : l c d c l e a r ( )

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

data , cmd = c o n v e r si o n (com , s )
commandwrt (cmd )
datawrt ( data )

except Ke yb o a rd In te r rup t : pass
l c d c l e a r ( )

40

### 3.4.4 Xbee Communication

In this experiment we will study to enable the serial communication through XBEE.

Enabling Serial communication in Pi
Refer to link :- Enabling Guide[10] (https://electrosome.com/uart-raspberry-pi-python/)

Code:-

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

GPIO. setmode (GPIO.BCM)
import s e r i a l

GPIO. s e t w a r ni n g s ( F al s e )
Motor1A = 13# s e t GPIO−13 as motor1 p in 1 Motor1B = 19 # s e t GPIO−19 as motor1 p in 2 Motor1E = 26 # s e t GPIO−26 as Enable p in o f motor1

GPIO. cle anup ( )
GPIO. se t up (Motor1A ,GPIO.OUT)# making motor p in1 as o u t p u t GPIO. se t up (Motor1B ,GPIO.OUT)# making motor p in2 as o u t p u t GPIO. se t up (Motor1E ,GPIO.OUT)# making e n a bl e as o u t p u t

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

# Func t ion name : t h r e a d f u n c

# In p u t : a ( any v a r i a b l e )

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

while 1 :
s e r= s e r i a l . S e r i a l ( ’ / dev /ttyAMA0 ’ ) s e r . b aud r a te =9600
s e r . w ri t e ( ” a ” . encode ( ) )
s l e e p ( 1 )
s e r . w ri t e ( ”b” . encode ( ) ) s l e e p ( 1 )

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

41

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

while 1 :
pwm. ChangeDutyCycle ( 3 0 )
GPIO. output (Motor1A ,GPIO.HIGH) GPIO. output (Motor1B ,GPIO.HIGH)
GPIO. output (Motor1E ,GPIO.HIGH)

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

42

### 3.4.5 Servo motors

We have given 3 ports on adaptor board to control the 3 servo motors and their enable pins are connected to the following Raspberry-pi pins:-
Servo motor | Raspberry pin(GPIO)
Servo1 | 18
Servo2 | 23
Servo3 | 24

Code:-

import RPi .GPIO a s GPIO # module t o c o n t r o l Pi GPIO c h a n n el s import time

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

# Func t ion name : r o t a t i o n

# In p u t : Angle in d e g r e e s

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

# Example c a l l : r o t a t i o n ( x )

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

try :
while 1 :
a n gl e = 90 # i t can range from 0 t o 360 d e g r e e s on time , o f f t i m e = r o t a t i o n ( a n gl e )
GPIO. output ( i 1 , True )
time . s l e e p ( on time / 1 0 0 0 ) # t ime in ms
GPIO. output ( i 1 , F al s e )
time . s l e e p ( o f f t i m e / 1 0 0 0 )

except Ke yb o a rd In te r rup t :
pass
GPIO. cle anup ( ) # a l l GPIO p i n s are c l e a r e d

43

### 3.4.6 Turning off pi with press of push button

In order to protect our SD card from getting corrupted we should shut down the Raspberry-Pi properly instead of powering it off directly.
So in order to do that we have put a intterupt switch on the Adaptor Board .When we will press the switch the Raspberry pi will be Switched off or Shut Down properly . We are using a Pull up register for checking the Input,so if button is pressed then output will be 0 as we are using it in pull up configuration
We have connected the interupt switch to GPIO 20 of raspberry pi.

Code:-

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

GPIO. setmode (GPIO.BCM)

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

44

### 3.4.7 Running program on booting of pi

If we want to run the code as soon as Raspberry-pi boots up you have to put your python code in bash.rc file.Refer to following link http://www.instructables.com/id/Raspberry-Pi-Launch-Python-script-on-startup/ (http://www.instructables.com/id/Raspberry-Pi-Launch-Python-script-on-startup/)

45

# Chapter 4

# References

1. https://www.raspberrypi.org/
2. http://en.wikipedia.org/wiki/Raspberry_Pi
3. https://www.raspberrypi.org/wp-content/uploads/2014/11/Raspberry_Pi_Family_A-annotated-15001.jpg (https://www.raspberrypi.org/wp-content/uploads/2014/11/Raspberry_Pi_Family_A-annotated-15001.jpg)
4. http://assets.windowsphone.com/3f82dfe6-a179-4ddf-9738-91989190c3fa/IoT-rpi2-board_InvariantCulture_Default.png (http://assets.windowsphone.com/3f82dfe6-a179-4ddf-9738-91989190c3fa/IoT-rpi2-board_InvariantCulture_Default.png)
5. http://en.wikipedia.org/wiki/Secure_Shell
6. http://www.webopedia.com/TERM/S/SSH.html
7. http://www.codemastershawn.com/library/tutorial/images/ssh.tunnel.overview.gif (http://www.codemastershawn.com/library/tutorial/images/ssh.tunnel.overview.gif)
8. http://mobaxterm.mobatek.net/
9. http://www.suntimebox.com/raspberry-pi-tutorial-course/week-3/day-5/ (http://www.suntimebox.com/raspberry-pi-tutorial-course/week-3/day-5/)
10. https://electrosome.com/uart-raspberry-pi-python/

46
