eYSIP-2017/Fi_Pi_/Documents/Manual/Hardware Manual/volt_sens1.PNG

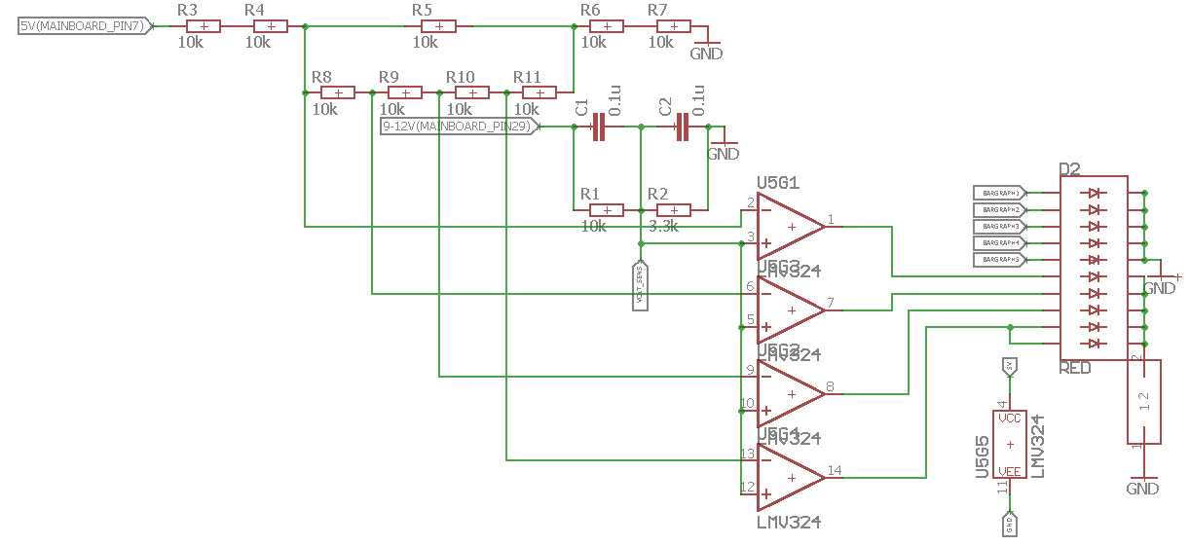
Documents/Manual/Hardware Manual/volt_sens1.PNG
