eYSIP-2017/Fi_Pi_/Documents/Manual/Software manual/adc.PNG

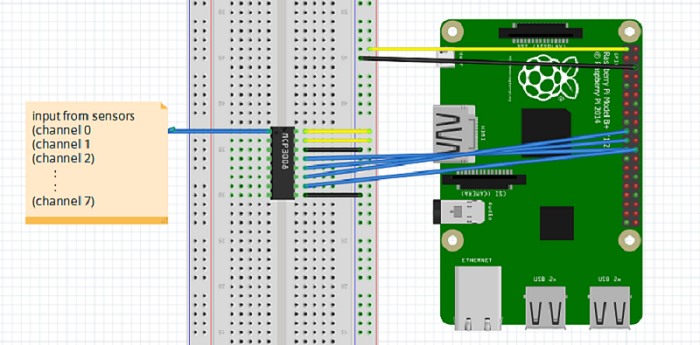
Documents/Manual/Software manual/adc.PNG
