eYSIP-2017/Fi_Pi_/Documents/Manual/Software manual/spi3.PNG

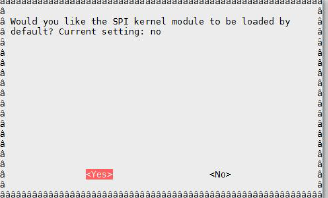
Documents/Manual/Software manual/spi3.PNG
