eYSIP-2017/Fi_Pi_/Documents/Manual/Software manual/spi4.PNG

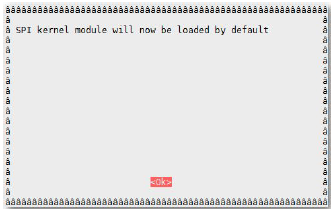
Documents/Manual/Software manual/spi4.PNG
