eYSIP-2017/Fi_Pi_/Documents/Manual/Software manual/spi5.PNG

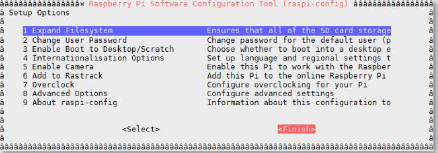
Documents/Manual/Software manual/spi5.PNG
