eYSIP-2017/Fi_Pi_/Documents/PCB_Schematics/Fi-Pi.brd

## EAGLE design Documents/PCB_Schematics/Fi-Pi.brd (2017-07-05)

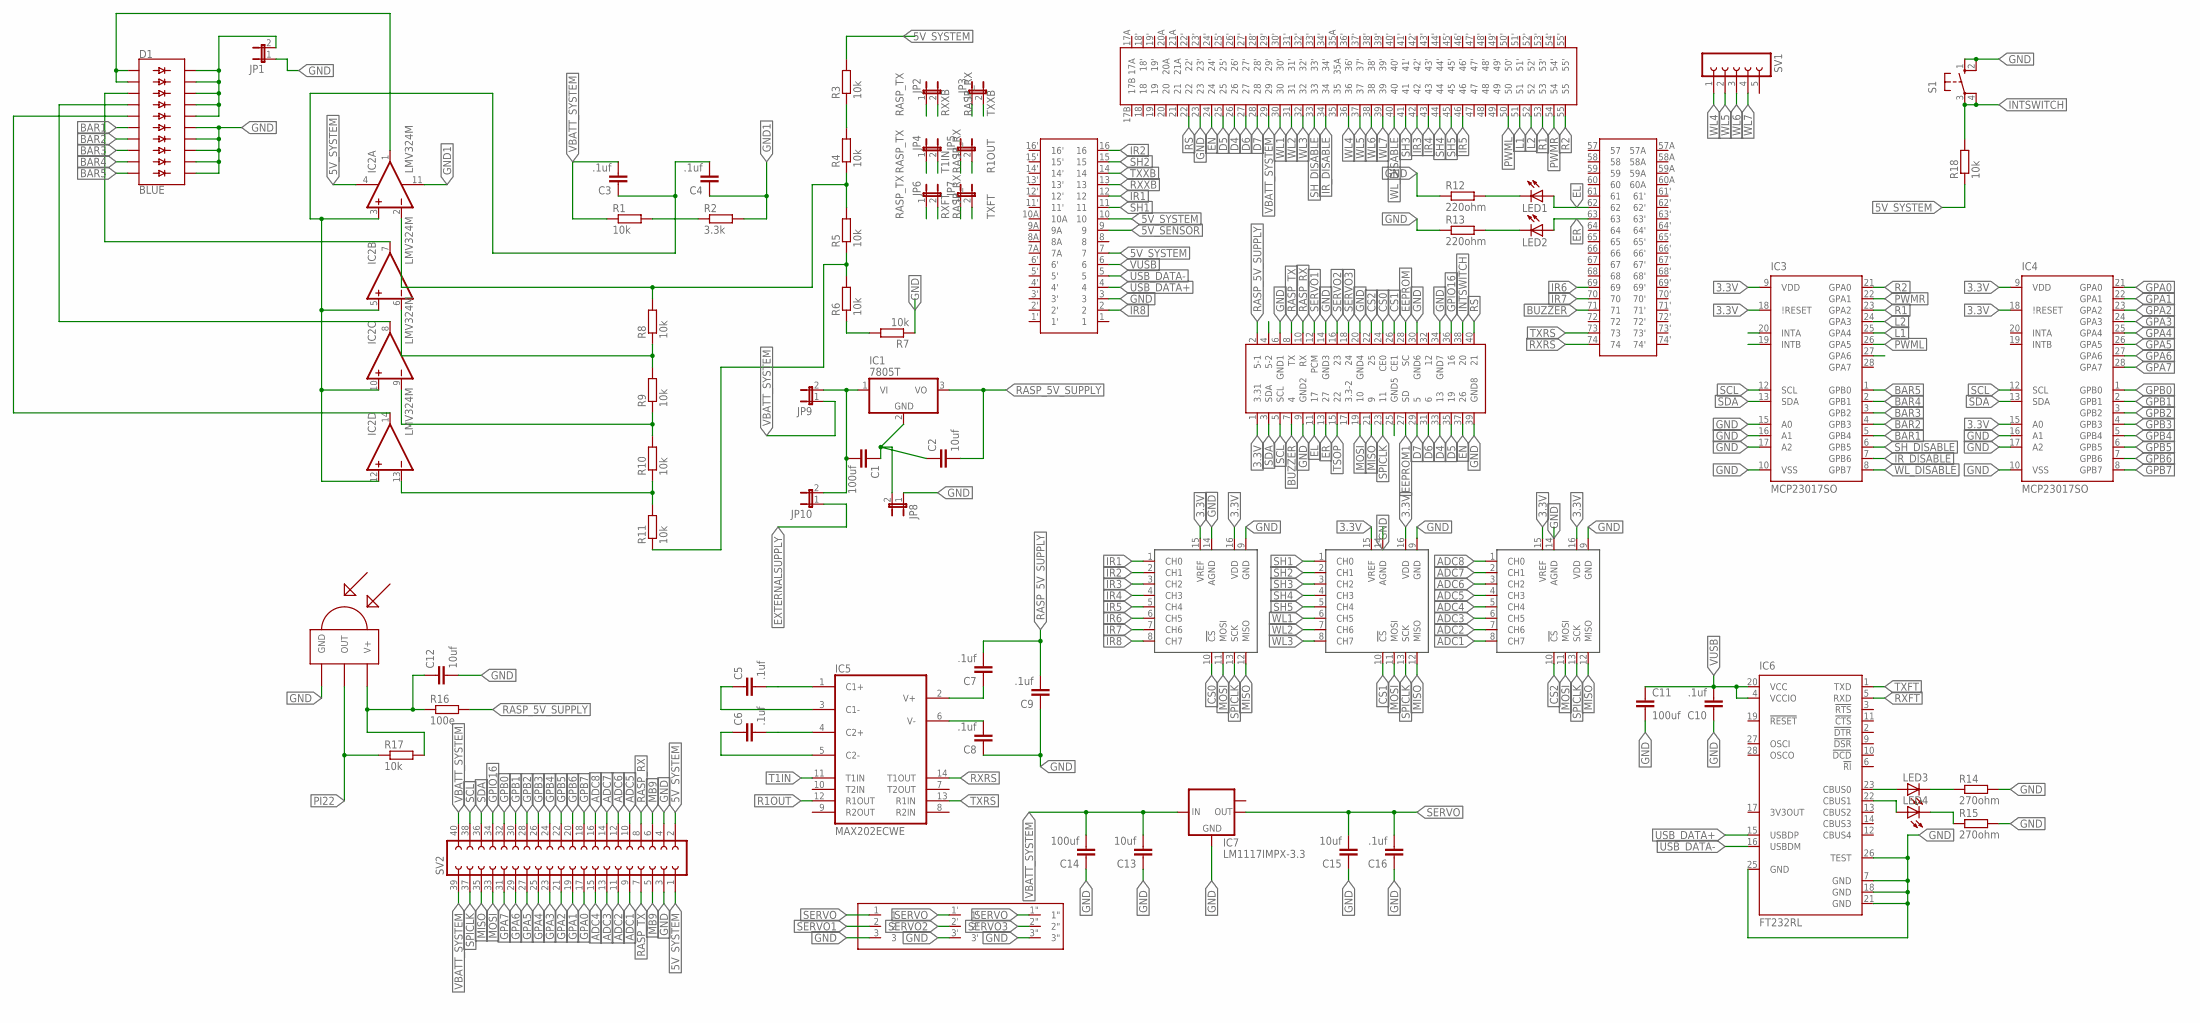
[picture p110: schematic Fi-Pi.sch]

Parts:
C1, C11, C14: 100uf; C1206
C2, C12, C13, C15: 10uf; C1206
C3, C4, C5, C6, C7, C8, C9, C10, C16: .1uf; C1206
D1: BLUE; LED_BARGRAPH_10
IC1: 7805T; TO220H
IC2: LMV324M; SO14
IC3, IC4: MCP23017SO; SO28W
IC5: MAX202ECWE; SO16L
IC6: FT232RL; SSOP28
IC7: LM1117IMPX-3.3; SOT223
JP1, JP2, JP3, JP4, JP5, JP6, JP7, JP8, JP9, JP10: JP1E; JP1
LED1, LED2, LED3, LED4: LED_E; LED_1206
R1, R3, R4, R5, R6, R7, R8, R9, R10, R11, R17, R18: 10k; R1206
R2: 3.3k; R1206
R12, R13: 220ohm; R1206
R14, R15: 270ohm; R1206
R16: 100e; R1206
S1: 10-XX; B3F-10XX
SV1: FE05-1
SV2: FE20-2
U$1: DAUGHTERBOARDDAUGHTERBOARD; DAUGHTERBOARD
U$2: MALE_HEADER; MALE_HEADER_PACKAGE
U$3, U$4, U$5: MCP3008SL; SO16
U$6: TSOP1738; TSOP17XX
U$7: SERVO

Connections:
3.3V: IC3.9 (VDD), IC3.18 (\!RESET), IC4.9 (VDD), IC4.15 (A0), IC4.18 (\!RESET), U$2.1 (3.31), U$3.15 (VREF), U$3.16 (VDD), U$4.15 (VREF), U$4.16 (VDD), U$5.15 (VREF), U$5.16 (VDD)
5V_SENSOR: U$1.9
5V_SYSTEM: IC2.4 (V+), R3.2, R18.1, SV2.1, SV2.2, U$1.7, U$1.10
A: D1.16 (C4), D1.17 (C3), D1.18 (C2), D1.19 (C1), D1.20 (C), JP1.2
ADC1: SV2.9, U$5.8 (CH7)
ADC2: SV2.11, U$5.7 (CH6)
ADC3: SV2.13, U$5.6 (CH5)
ADC4: SV2.15, U$5.5 (CH4)
ADC5: SV2.10, U$5.4 (CH3)
ADC6: SV2.12, U$5.3 (CH2)
ADC7: SV2.14, U$5.2 (CH1)
ADC8: SV2.16, U$5.1 (CH0)
BAR1: D1.6 (A5), IC3.5 (GPB4)
BAR2: D1.7 (A6), IC3.4 (GPB3)
BAR3: D1.8 (A7), IC3.3 (GPB2)
BAR4: D1.9 (A8), IC3.2 (GPB1)
BAR5: D1.10 (A9), IC3.1 (GPB0)
BUZZER: U$1.71, U$2.7 (4)
CS0: U$2.24 (CE0), U$3.10 (!CS)
CS1: U$2.26 (CE1), U$4.10 (!CS)
CS2: U$2.22 (25), U$5.10 (!CS)
D4: U$1.26, U$2.33 (13)
D5: U$1.25, U$2.35 (19)
D6: U$1.27, U$2.31 (6)
D7: U$1.28, U$2.29 (5)
EEPROM: U$2.28 (SC)
EEPROM1: U$2.27 (SD)
EL: LED1.A, U$1.62, U$2.11 (17)
EN: U$1.24, U$2.37 (26)
ER: LED2.A, U$1.63, U$2.13 (27)
EXTERNALSUPPLY: JP10.1
GND: C8.1, C9.1, C10.1, C11.2, C12.2, C13.1, C14.1, C15.1, C16.1, D1.11 (C9), D1.12 (C8), D1.13 (C7), D1.14 (C6), D1.15 (C5), IC3.10 (VSS), IC3.15 (A0), IC3.16 (A1), IC3.17 (A2), IC4.10 (VSS), IC4.16 (A1), IC4.17 (A2), IC5.15 (GND), IC6.7 (GND), IC6.18 (GND), IC6.21 (GND), IC6.25 (GND), IC6.26 (TEST), IC7.1 (GND), JP1.1, JP8.1, R7.1, R12.1, R13.1, R14.2, R15.2, S1.1 (S), S1.2 (S1), SV2.3, SV2.4, U$1.3, U$1.23, U$2.6 (GND1), U$2.9 (GND2), U$2.14 (GND3), U$2.20 (GND4), U$2.25 (GND5), U$2.30 (GND6), U$2.34 (GND7), U$2.39 (GND8), U$3.9 (GND), U$3.14 (AGND), U$4.9 (GND), U$4.14 (AGND), U$5.9 (GND), U$5.14 (AGND), U$6.GND, U$7.3, U$7.3", U$7.3'
GND1: C4.1, IC2.11 (V-), R2.2
GPA0: IC4.21 (GPA0), SV2.17
GPA1: IC4.22 (GPA1), SV2.19
GPA2: IC4.23 (GPA2), SV2.21
GPA3: IC4.24 (GPA3), SV2.23
GPA4: IC4.25 (GPA4), SV2.25
GPA5: IC4.26 (GPA5), SV2.27
GPA6: IC4.27 (GPA6), SV2.29
GPA7: IC4.28 (GPA7), SV2.31
GPB0: IC4.1 (GPB0), SV2.32
GPB1: IC4.2 (GPB1), SV2.30
GPB2: IC4.3 (GPB2), SV2.28
GPB3: IC4.4 (GPB3), SV2.26
GPB4: IC4.5 (GPB4), SV2.24
GPB5: IC4.6 (GPB5), SV2.22
GPB6: IC4.7 (GPB6), SV2.20
GPB7: IC4.8 (GPB7), SV2.18
GPIO16: SV2.34, U$2.36 (16)
INTSWITCH: R18.2, S1.3, S1.4 (P1), U$2.38 (20)
IR1: U$1.12, U$3.1 (CH0)
IR2: U$1.16, U$3.2 (CH1)
IR3: U$1.42, U$3.3 (CH2)
IR4: U$1.43, U$3.4 (CH3)
IR5: U$1.46, U$3.5 (CH4)
IR6: U$1.69, U$3.6 (CH5)
IR7: U$1.70, U$3.7 (CH6)
IR8: U$1.2, U$3.8 (CH7)
IR_DISABLE: IC3.7 (GPB6), U$1.34
L1: IC3.25 (GPA4), U$1.51
L2: IC3.24 (GPA3), U$1.52
MB9: SV2.5, SV2.6
MISO: SV2.35, U$2.21 (9), U$3.12 (MISO), U$4.12 (MISO), U$5.12 (MISO)
MOSI: SV2.33, U$2.19 (10), U$3.11 (MOSI), U$4.11 (MOSI), U$5.11 (MOSI)
unnamed: C1.1, C2.1, IC1.2 (GND), JP8.2
unnamed: R5.1, R6.2, R11.1
unnamed: C3.1, C4.2, IC2.3 (+IN), IC2.5 (+IN), IC2.10 (+IN), IC2.12 (+IN), R1.2, R2.1
unnamed: R3.1, R4.2
unnamed: IC2.2 (-IN), R4.1, R5.2, R8.2
unnamed: IC2.6 (-IN), R8.1, R9.2
unnamed: R6.1, R7.2
unnamed: IC2.9 (-IN), R9.1, R10.2
unnamed: IC2.13 (-IN), R10.1, R11.2
unnamed: D1.1 (A), D1.2 (A1), IC2.1 (OUT)
unnamed: C5.1, IC5.3 (C1-)
unnamed: D1.4 (A3), IC2.8 (OUT)
unnamed: D1.5 (A4), IC2.14 (OUT)
unnamed: LED1.C, R12.2
unnamed: LED2.C, R13.2
unnamed: C5.2, IC5.1 (C1+)
unnamed: C6.2, IC5.4 (C2+)
unnamed: C6.1, IC5.5 (C2-)
unnamed: LED4.C, R15.1
unnamed: D1.3 (A2), IC2.7 (OUT)
unnamed: LED3.C, R14.1
unnamed: IC6.23 (CBUS0), LED3.A
unnamed: IC6.22 (CBUS1), LED4.A
unnamed: C7.1, IC5.2 (V+)
unnamed: C8.2, IC5.6 (V-)
unnamed: C12.1, R16.1, R17.2, U$6.V+
PI4: U$2.4 (5-2)
PI22: R17.1, U$6.OUT
PWML: IC3.26 (GPA5), U$1.50
PWMR: IC3.22 (GPA1), U$1.54
R1: IC3.23 (GPA2), U$1.53
R1OUT: IC5.12 (R1OUT), JP5.2
R2: IC3.21 (GPA0), U$1.55
RASP_5V_SUPPLY: C2.2, C7.2, C9.2, IC1.3 (VO), R16.2, U$2.2 (5-1)
RASP_RX: JP3.1, JP5.1, JP7.1, SV2.8, U$2.10 (RX)
RASP_TX: JP2.1, JP4.1, JP6.1, SV2.7, U$2.8 (TX)
RS: U$1.22, U$2.40 (21)
RXFT: IC6.5 (RXD), JP6.2
RXRS: IC5.14 (T1OUT), U$1.74
RXXB: JP2.2, U$1.13
SCL: IC3.12 (SCL), IC4.12 (SCL), SV2.38, U$2.5 (SCL)
SDA: IC3.13 (SDA), IC4.13 (SDA), SV2.36, U$2.3 (SDA)
SERVO: C15.2, C16.2, IC7.2 (OUT), U$7.1, U$7.1", U$7.1'
SERVO1: U$2.12 (PCM), U$7.2
SERVO2: U$2.16 (23), U$7.2'
SERVO3: U$2.18 (24), U$7.2"
SH1: U$1.11, U$4.1 (CH0)
SH2: U$1.15, U$4.2 (CH1)
SH3: U$1.41, U$4.3 (CH2)
SH4: U$1.44, U$4.4 (CH3)
SH5: U$1.45, U$4.5 (CH4)
SH_DISABLE: IC3.6 (GPB5), U$1.33
SPICLK: SV2.37, U$2.23 (11), U$3.13 (SCK), U$4.13 (SCK), U$5.13 (SCK)
T1IN: IC5.11 (T1IN), JP4.2
TSOP: U$2.15 (22)
TXFT: IC6.1 (TXD), JP7.2
TXRS: IC5.13 (R1IN), U$1.73
TXXB: JP3.2, U$1.14
USB_DATA+: IC6.15 (USBDP), U$1.4
USB_DATA-: IC6.16 (USBDM), U$1.5
VBATT_SYSTEM: C1.2, C3.2, C13.2, C14.2, IC1.1 (VI), IC7.3 (IN), JP9.1, JP9.2, JP10.2, R1.1, SV2.39, SV2.40, U$1.29
VCC: IC5.16 (VCC)
VUSB: C10.2, C11.1, IC6.4 (VCCIO), IC6.20 (VCC), U$1.6
WL1: U$1.30, U$4.6 (CH5)
WL2: U$1.31, U$4.7 (CH6)
WL3: U$1.32, U$4.8 (CH7)
WL4: SV1.1, U$1.36
WL5: SV1.2, U$1.37
WL6: SV1.3, U$1.38
WL7: SV1.4, U$1.39
WL_DISABLE: IC3.8 (GPB7), U$1.40

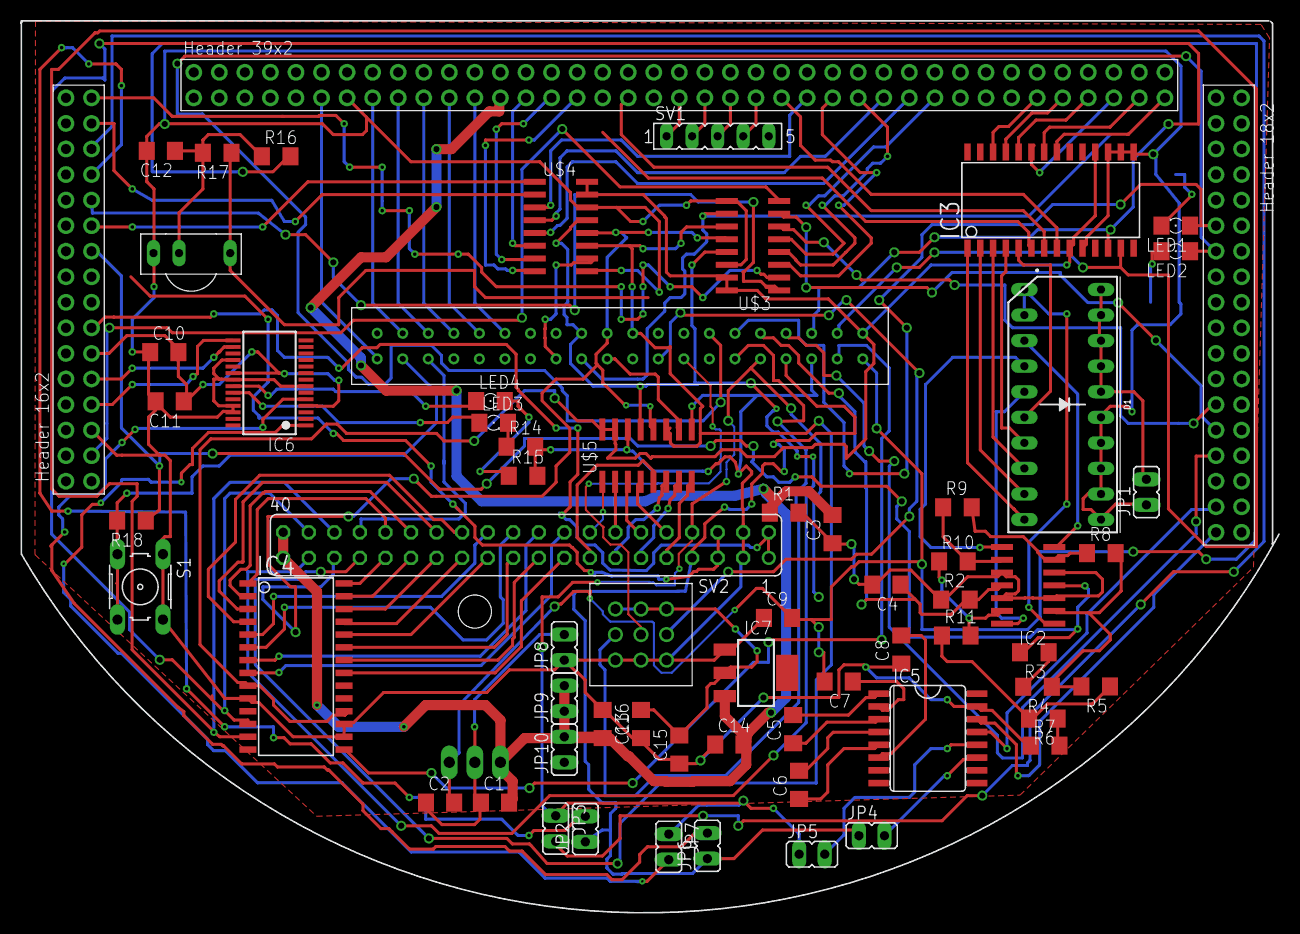
[picture p111: board Fi-Pi.brd from above]

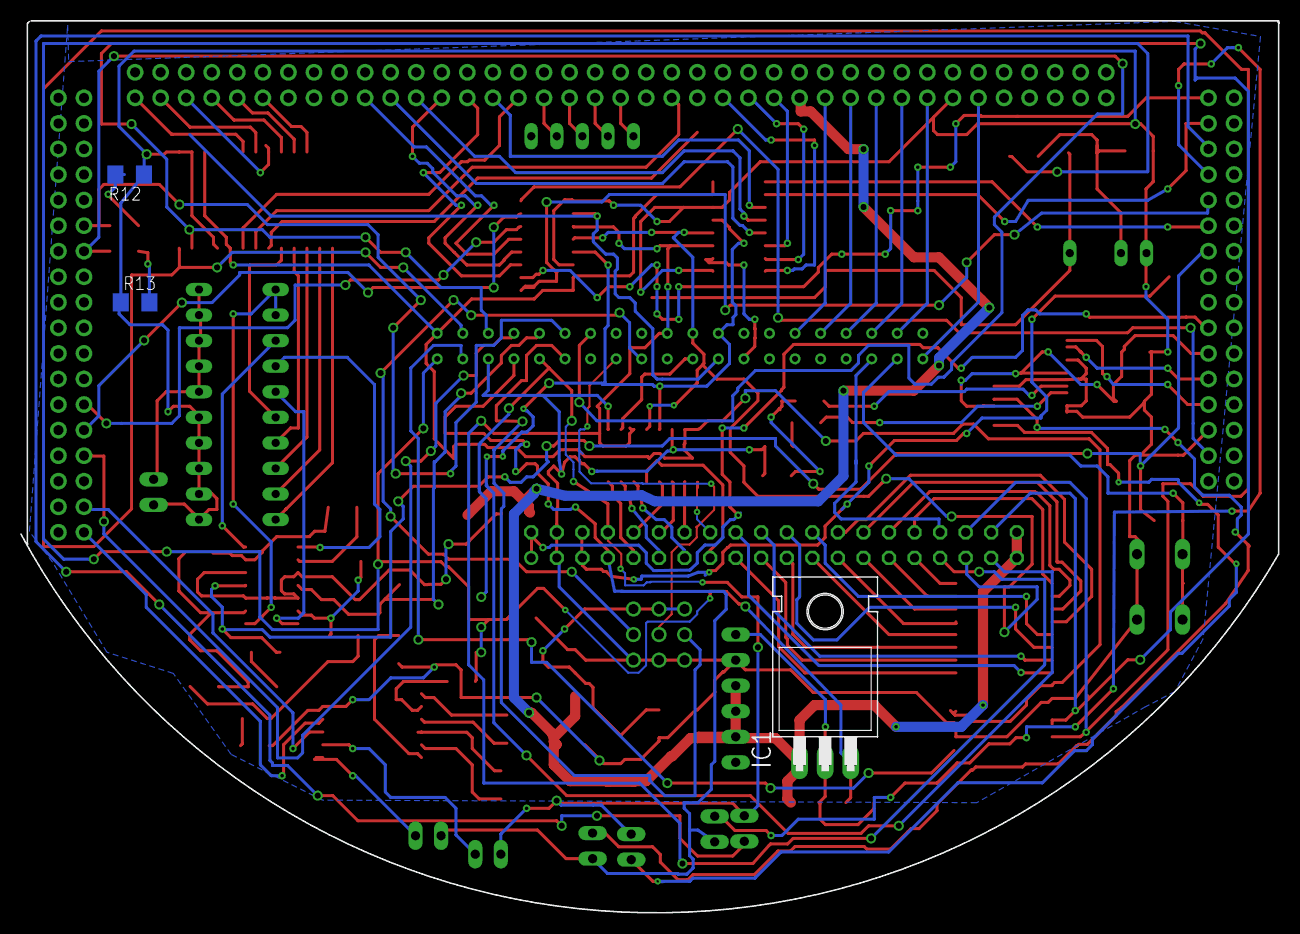
[picture p112: board Fi-Pi.brd from below]

Board: 2 copper layers, 125.1 x 88.6 mm, 66 parts (3 on the bottom side), 129 nets.
