eYSIP-2017/Fi_Pi_/Documents/Manual/Software manual/adc.py

import spidev#spi library to control spi devices
import RPi.GPIO as GPIO #To control Pi GPIO channels
from time import sleep # time library to include sleep function


spi=spidev.SpiDev() # Open SPI bus  to create spi object
spi.open(0,0)# opened in bus 0 device 0

# Function to read SPI data from MCP3008 chip
# Channel must be an integer 0-7
# Function name :getADC
# Input : channel
# Output : analog data converted to digital in 10 bit resolution
# Example call: getADC(channel)
def getADC(channel):
    if(channel>7) or (channel<0):
        return -1
    r=spi.xfer([1,(8+channel) << 4,0])
    adc_out=((r[1]&3) << 8) + r[2]
    #print(adc_out)
    #if(adc_out<600 and adc_out>100):
        #print("1")
    #else:
        #print("0")
   
    print("adc output:{0:4d}".format(adc_out))


# Loop to get8 simultaneous analog values from 8 analog sensors
#and displaying the corresponding digital  
#value using spi communication
while 1:
    for i in range(8):
        print("---------------------------------------------------------")
        print("analogsensor")
        print(i)
        getADC(i)
        print("---------------------------------------------------------")
    sleep(2)
