eYSIP-2017/Fi_Pi_/(commit log)

2017-06-06 Added ADC Program
2017-06-06 Added pwm_motot_control
2017-06-06 Added wheel_encoder
2017-06-06 Added position encoder program with threads
2017-06-06 Added Xbee program with threads
2017-06-12 eagle backup
    [adapter.sch, pcb.brd, power.brd, power.sch, tx-rx.sch]
2017-06-27 adding files
    [FI-pi Milanpreet Singh.sch, FIPI_shematics.brd, FIPI_shematics.sch, Fi-pi Milanpreet Singh.brd]
2017-07-05 added changes
    [FI-pi Milanpreet Singh.sch, FIPI_shematics.brd, FIPI_shematics.sch, Fi-Pi.brd, Fi-Pi.sch, Fi-pi Milanpreet Singh.brd]
2017-07-07 added report
    [Fi-Pi.brd, Fi-Pi.sch, Revised.sch]
